ShaheerSajid/ntiny/design/core/csr_unit/src/csr_unit.sv

import common_pkg::*;
import core_pkg::*;

module csr_unit (
	input clk_i,
  input reset_i,

	input [63:0] mtime_i,        // CLINT mtime for TIME/TIMEH CSRs

	input csr_op_e csr_cmd_i,
	input csr_reg_e csr_addr_i,
	input onebit_sig_e csr_use_immediate_i,
	input [31:0] imm_i,
	input [31:0] reg_i,

	input onebit_sig_e csr_instret_trigger_i,
	input onebit_sig_e stop_counters_i,
	input onebit_sig_e float_valid_i,
	output roundmode_e roundmode_o,
	input float_status_e float_status_i,

///////Trap Signals (interrupts + exceptions)
  input trap_valid_i,
  input trap_to_s_i,              // trap delegated to S-mode
  input [31:0]ecause_i,
  input [31:0]epc_i,
  input [31:0]mtval_i,
  input [31:0]interrupt_src_i,
  // SEIP HW signal from PLIC ctx-1 output. Per RISC-V spec mip.SEIP is
  // a UNION of HW (this input) and SW-set bit (CSR write to mip[9]).
  // We keep _MIP[9] for the SW component and OR this signal into mip
  // reads / ip_o so interrupt_ctrl + Linux see HW SEIP without losing
  // any SW-injected SEIP that OpenSBI's legacy timer flow may set.
  input ext_irq_s_hw_i,
  input ret_i,                    // MRET
  input sret_i,                   // SRET

  output [31:0]ip_o,
  output [31:0]ie_o,
  output [31:0]vec_o,             // mtvec or stvec (selected by trap_to_s_i)
  // Phase 4 trap revamp: wb_trap_unit needs the unmuxed values so it
  // can pick the redirect target from its own delegation decision.
  output [31:0]mtvec_o,
  output [31:0]stvec_o,
  output [31:0]status_o,
  output [31:0]epc_o,             // mepc (for MRET)
  output [31:0]sepc_o,            // sepc (for SRET)
  output [1:0] priv_o,            // current privilege level
  output [31:0]medeleg_o,
  output [31:0]mideleg_o,
  output [31:0]satp_o,
  output logic        menvcfg_adue_o,   // menvcfgh[29] — Svadu HW A/D update enable
  output logic        menvcfg_stce_o,   // menvcfgh[31] — Sstc S-mode timer enable
  output logic [63:0] stimecmp_o,       // S-mode timer compare (Sstc)
  output logic [31:0] pmpcfg_o  [4],
  output logic [31:0] pmpaddr_o [16],

	output logic [31:0]csr_value_o,
	output logic       csr_invalid_o  // 1 when accessed CSR address is unimplemented
	);

	// ── Privilege masks ──────────────────────────────────────────
	// SSTATUS: writable bits visible through sstatus view of mstatus
`ifdef FPU
	localparam SSTATUS_WMASK = 32'h000C_6122;  // SIE[1], SPIE[5], SPP[8], FS[14:13], SUM[18], MXR[19]
	localparam SSTATUS_RMASK = 32'h800C_6122;  // + SD[31] for reads
	localparam MSTATUS_WMASK = 32'h007E_79AA;  // all writable mstatus bits
`else
	localparam SSTATUS_WMASK = 32'h000C_0122;
	localparam SSTATUS_RMASK = 32'h000C_0122;
	localparam MSTATUS_WMASK = 32'h007E_19AA;
`endif
	// S-mode interrupt bits: SSIE[1], STIE[5], SEIE[9]
	localparam S_INT_MASK = 32'h0000_0222;

	// ── Registers ────────────────────────────────────────────────
	logic [31:0] _MSTATUS;
	logic [31:0] _MIE;
	logic [31:0] _MTVEC;
	logic [31:0] _MEPC;
	logic [31:0] _MCAUSE;
	logic [31:0] _MTVAL;
	logic [31:0] _MSCRATCH;
	logic [31:0] _MIP;
	logic [31:0] _MCYCLE;
	logic [31:0] _MINSTRET;
	logic [31:0] _MCYCLEH;
	logic [31:0] _MINSTRETH;
	logic [31:0] _MCOUNTINHIBIT;
	logic [31:0] _FFLAGS;
	logic [31:0] _FRM;
	// S-mode registers
	logic [31:0] _STVEC;
	logic [31:0] _SSCRATCH;
	logic [31:0] _SEPC;
	logic [31:0] _SCAUSE;
	logic [31:0] _STVAL;
	logic [31:0] _SATP;
	logic [31:0] _MEDELEG;
	logic [31:0] _MIDELEG;
	logic [31:0] _MCOUNTEREN;
	logic [31:0] _SCOUNTEREN;
	logic [31:0] _MENVCFG;
	logic [31:0] _MENVCFGH;
	logic [31:0] _SENVCFG;
	// Sstc — S-mode timer compare register (split LO/HI for RV32)
	logic [31:0] _STIMECMP;
	logic [31:0] _STIMECMPH;
	// Trigger Module CSRs (Spec 1.0 §5.5). One implementation slot
	// (tselect=0). Storage allows writes to round-trip; no match logic
	// is wired into the pipeline yet, so triggers configured here do
	// not actually fire — tinfo therefore advertises type=0 (no real
	// trigger) and OpenOCD/GDB fall back to software breakpoints. The
	// register interface satisfies the spec's "read/write CSR" contract
	// and stops abstract regaccess from raising csr_invalid for these
	// addresses, which OpenOCD reads during examination.
	logic [31:0] _TSELECT;
	logic [31:0] _TDATA1;
	logic [31:0] _TDATA2;
	logic [31:0] _TDATA3;
	logic [31:0] _TCONTROL;
	// PMP CSRs
	logic [31:0] _PMPCFG  [4];
	logic [31:0] _PMPADDR [16];
	// Privilege level (2'b11=M, 2'b01=S, 2'b00=U)
	logic [1:0]  priv_level;

	// ── CSR select logic ─────────────────────────────────────────
	logic MSTATUS_sel, SSTATUS_sel;
	logic MIE_sel, SIE_sel;
	logic MTVEC_sel, STVEC_sel;
	logic MEPC_sel, SEPC_sel;
	logic MCAUSE_sel, SCAUSE_sel;
	logic MTVAL_sel, STVAL_sel;
	logic MSCRATCH_sel, SSCRATCH_sel;
	logic MIP_sel, SIP_sel;
	logic MCYCLE_sel, MINSTRET_sel, MCYCLEH_sel, MINSTRETH_sel;
	logic MCOUNTINHIBIT_sel;
	logic FFLAGS_sel, FRM_sel, FCSR_sel;
	logic SATP_sel;
	logic MEDELEG_sel, MIDELEG_sel;
	logic MCOUNTEREN_sel, SCOUNTEREN_sel;
	logic MENVCFG_sel, MENVCFGH_sel, SENVCFG_sel;
	logic STIMECMP_sel, STIMECMPH_sel;
	logic TSELECT_sel, TDATA1_sel, TDATA2_sel, TDATA3_sel, TINFO_sel, TCONTROL_sel;

	assign MSTATUS_sel      = csr_addr_i == MSTATUS;
	assign SSTATUS_sel      = csr_addr_i == SSTATUS;
	assign MIE_sel          = csr_addr_i == MIE;
	assign SIE_sel          = csr_addr_i == SIE;
	assign MTVEC_sel        = csr_addr_i == MTVEC;
	assign STVEC_sel        = csr_addr_i == STVEC;
	assign MEPC_sel         = csr_addr_i == MEPC;
	assign SEPC_sel         = csr_addr_i == SEPC;
	assign MCAUSE_sel       = csr_addr_i == MCAUSE;
	assign SCAUSE_sel       = csr_addr_i == SCAUSE;
	assign MTVAL_sel        = csr_addr_i == MTVAL;
	assign STVAL_sel        = csr_addr_i == SBADADDR;
	assign MSCRATCH_sel     = csr_addr_i == MSCRATCH;
	assign SSCRATCH_sel     = csr_addr_i == SSCRATCH;
	assign MIP_sel          = csr_addr_i == MIP;
	assign SIP_sel          = csr_addr_i == SIP;
	assign MCYCLE_sel       = csr_addr_i == MCYCLE;
	assign MINSTRET_sel     = csr_addr_i == MINSTRET;
	assign MCYCLEH_sel      = csr_addr_i == MCYCLEH;
	assign MINSTRETH_sel    = csr_addr_i == MINSTRETH;
	assign MCOUNTINHIBIT_sel= csr_addr_i == MCOUNTINHIBIT;
	assign FFLAGS_sel       = csr_addr_i == FFLAGS;
	assign FRM_sel          = csr_addr_i == FRM;
	assign FCSR_sel         = csr_addr_i == FCSR;
	assign SATP_sel         = csr_addr_i == SATP;
	assign MEDELEG_sel      = csr_addr_i == MEDELEG;
	assign MIDELEG_sel      = csr_addr_i == MIDELEG;
	assign MCOUNTEREN_sel   = csr_addr_i == MCOUNTEREN;
	assign SCOUNTEREN_sel   = csr_addr_i == SCOUNTEREN;
	assign MENVCFG_sel      = csr_addr_i == MENVCFG;
	assign MENVCFGH_sel     = csr_addr_i == MENVCFGH;
	assign SENVCFG_sel      = csr_addr_i == SENVCFG;
	assign STIMECMP_sel     = csr_addr_i == STIMECMP;
	assign STIMECMPH_sel    = csr_addr_i == STIMECMPH;
	assign TSELECT_sel      = csr_addr_i == TSELECT;
	assign TDATA1_sel       = csr_addr_i == TDATA1;
	assign TDATA2_sel       = csr_addr_i == TDATA2;
	assign TDATA3_sel       = csr_addr_i == TDATA3;
	assign TINFO_sel        = csr_addr_i == TINFO;
	assign TCONTROL_sel     = csr_addr_i == TCONTROL;

	// True when the IE-stage opcode is one of the CSR ops. Forward
	// declared so the PMP / SEED / etc blocks below don't trip
	// Synth 8-6901 use-before-decl. The full-driver assignment lives
	// later at its natural point.
	wire csr_active;


	// ── CSR write data ───────────────────────────────────────────
	logic [31:0] csr_data;
	assign csr_data = (csr_use_immediate_i == TRUE) ? imm_i : reg_i;

	// ── Counters ─────────────────────────────────────────────────
	logic [63:0] csr_cycle_update;
	logic [63:0] csr_instret_update;
	assign csr_cycle_update   = (!_MCOUNTINHIBIT[0] && !stop_counters_i) ? {_MCYCLEH,_MCYCLE} + 1 : {_MCYCLEH,_MCYCLE};
	assign csr_instret_update = (!_MCOUNTINHIBIT[2] && csr_instret_trigger_i && !stop_counters_i) ? {_MINSTRETH,_MINSTRET} + 1 : {_MINSTRETH,_MINSTRET};

	// ── Privilege level register ─────────────────────────────────
	always_ff @(posedge clk_i or posedge reset_i) begin
		if (reset_i)
			priv_level <= 2'b11;  // M-mode
		else if (trap_valid_i) begin
			priv_level <= trap_to_s_i ? 2'b01 : 2'b11;
		end else if (ret_i)
			priv_level <= _MSTATUS[12:11];  // MPP
		else if (sret_i)
			priv_level <= {1'b0, _MSTATUS[8]};  // {0, SPP}
	end

	// ── MSTATUS (manual — handles sstatus view + trap/ret) ──────
	// MSTATUS update — combines IE-stage csr_cmd writes with trap/ret
	// entry updates in the same cycle. This is required because the
	// pipeline captures the async-trap epc as pc_id (the instruction
	// AFTER the IE-stage one), implying the IE-stage CSR write has
	// effectively committed. If we suppressed the CSR write whenever
	// trap_valid_i fired, the kernel would skip past the squashed
	// instruction and lose its effect.
	//
	// Smoking gun (Linux boot, 2026-04-28): default_idle_call's
	// csrrsi sstatus,2 (set SIE) was being suppressed when a timer
	// trap fired on the same cycle. Kernel resumed past csrrsi with
	// SIE still 0. do_idle's SIE-set check then triggered WARN_ON
	// in kernel/sched/idle.c:228.
	//
	// Two-step compute (combinational):
	//   1. csrrw_next: apply the IE-stage CSR write to _MSTATUS
	//   2. mstatus_next: apply trap/ret bit overrides ON TOP of
	//      csrrw_next (so the trap entry sees the post-csr SIE
	//      when it computes SPIE).
	logic [31:0] csrrw_next;
	always_comb begin
		csrrw_next = _MSTATUS;
		if (csr_cmd_i == WRITE_CSR && MSTATUS_sel)
			csrrw_next = (_MSTATUS & ~MSTATUS_WMASK) | (csr_data & MSTATUS_WMASK);
		else if (csr_cmd_i == SET_CSR && MSTATUS_sel)
			csrrw_next = _MSTATUS | (csr_data & MSTATUS_WMASK);
		else if (csr_cmd_i == CLEAR_CSR && MSTATUS_sel)
			csrrw_next = _MSTATUS & ~(csr_data & MSTATUS_WMASK);
		else if (csr_cmd_i == WRITE_CSR && SSTATUS_sel)
			csrrw_next = (_MSTATUS & ~SSTATUS_WMASK) | (csr_data & SSTATUS_WMASK);
		else if (csr_cmd_i == SET_CSR && SSTATUS_sel)
			csrrw_next = _MSTATUS | (csr_data & SSTATUS_WMASK);
		else if (csr_cmd_i == CLEAR_CSR && SSTATUS_sel)
			csrrw_next = _MSTATUS & ~(csr_data & SSTATUS_WMASK);
	end

	logic [31:0] mstatus_next;
	always_comb begin
		mstatus_next = csrrw_next;
		if (trap_valid_i) begin
			if (trap_to_s_i) begin
				// S-mode trap entry: SPP=priv[0], SPIE=post-csr SIE, SIE=0
				mstatus_next[8] = priv_level[0];
				mstatus_next[5] = csrrw_next[1];
				mstatus_next[1] = 1'b0;
			end else begin
				// M-mode trap entry: MPP=priv, MPIE=post-csr MIE, MIE=0
				mstatus_next[12:11] = priv_level;
				mstatus_next[7]     = csrrw_next[3];
				mstatus_next[3]     = 1'b0;
			end
		end else if (ret_i) begin
			// MRET: MIE=MPIE, MPIE=1, MPP=U(00); clear MPRV if MPP!=M
			mstatus_next[3]     = csrrw_next[7];
			mstatus_next[7]     = 1'b1;
			mstatus_next[12:11] = 2'b00;
			mstatus_next[17]    = (csrrw_next[12:11] == 2'b11) ? csrrw_next[17] : 1'b0;
		end else if (sret_i) begin
			// SRET: SIE=SPIE, SPIE=1, SPP=0
			mstatus_next[1] = csrrw_next[5];
			mstatus_next[5] = 1'b1;
			mstatus_next[8] = 1'b0;
		end
	end

	always_ff @(posedge clk_i or posedge reset_i) begin
		if (reset_i)
			_MSTATUS <= 32'h0;
		else
			_MSTATUS <= mstatus_next;
	end

	// ── MIE (manual — handles sie view) ──────────────────────────
	always_ff @(posedge clk_i or posedge reset_i) begin
		if (reset_i) begin
			_MIE <= 32'h0;
		end else if (csr_cmd_i == WRITE_CSR && MIE_sel) begin
			_MIE <= csr_data;
		end else if (csr_cmd_i == SET_CSR && MIE_sel) begin
			_MIE <= _MIE | csr_data;
		end else if (csr_cmd_i == CLEAR_CSR && MIE_sel) begin
			_MIE <= _MIE & ~csr_data;
		end else if (csr_cmd_i == WRITE_CSR && SIE_sel) begin
			_MIE <= (_MIE & ~S_INT_MASK) | (csr_data & S_INT_MASK);
		end else if (csr_cmd_i == SET_CSR && SIE_sel) begin
			_MIE <= _MIE | (csr_data & S_INT_MASK);
		end else if (csr_cmd_i == CLEAR_CSR && SIE_sel) begin
			_MIE <= _MIE & ~(csr_data & S_INT_MASK);
		end
	end

	// ── MIP (manual — handles sip view + external source update) ─
	always_ff @(posedge clk_i or posedge reset_i) begin
		if (reset_i) begin
			_MIP <= 32'h0;
		end else if (csr_cmd_i == WRITE_CSR && MIP_sel) begin
			_MIP <= csr_data;
		end else if (csr_cmd_i == SET_CSR && MIP_sel) begin
			_MIP <= _MIP | csr_data;
		end else if (csr_cmd_i == CLEAR_CSR && MIP_sel) begin
			_MIP <= _MIP & ~csr_data;
		end else if (csr_cmd_i == WRITE_CSR && SIP_sel) begin
			// Only SSIP (bit 1) is writable through sip
			_MIP <= (_MIP & ~32'h2) | (csr_data & 32'h2);
		end else if (csr_cmd_i == SET_CSR && SIP_sel) begin
			_MIP <= _MIP | (csr_data & 32'h2);
		end else if (csr_cmd_i == CLEAR_CSR && SIP_sel) begin
			_MIP <= _MIP & ~(csr_data & 32'h2);
		end else begin
			// Hardware update from external sources.
			// MTIP[7] / MEIP[11] / MSIP[3] are HW-driven level signals from
			// CLINT/PLIC — they must reflect interrupt_src_i live.
			// STIP[5] / SEIP[9] / SSIP[1] are SOFTWARE-controlled (M-mode
			// writes them via mip to inject S-mode interrupts; S-mode can
			// clear via sip). They MUST NOT be clobbered by HW sources —
			// interrupt_src_i has zero in those positions, so a blind
			// assign would lose every csrsi mip,STIP that OpenSBI does in
			// its legacy timer flow → Linux never sees timer ticks → the
			// scheduler never preempts → kernel livelocks in shmem cmpxchg
			// loops after spawning /init. (Reproduced as Linux page-fault
			// livelock past 91M cycles with zero timer traps.)
			// Hold SW bits (mask 0x222), refresh HW bits (mask 0x888).
			_MIP <= (_MIP & 32'h0000_0222) | (interrupt_src_i & 32'h0000_0888);
		end
	end

	// ── Counter registers (unchanged) ────────────────────────────
	csr_register_32 #(32'h0) csr_mcycle     (.clk_i(clk_i),.reset_i(reset_i),.csr_cmd_i(csr_cmd_i),.enable(MCYCLE_sel),
	                                          .wdata(csr_data),.update(csr_cycle_update[31:0]), .csr(_MCYCLE));
	csr_register_32 #(32'h0) csr_minstret   (.clk_i(clk_i),.reset_i(reset_i),.csr_cmd_i(csr_cmd_i),.enable(MINSTRET_sel),
	                                          .wdata(csr_data),.update(csr_instret_update[31:0]), .csr(_MINSTRET));
	csr_register_32 #(32'h0) csr_mcycleh    (.clk_i(clk_i),.reset_i(reset_i),.csr_cmd_i(csr_cmd_i),.enable(MCYCLEH_sel),
	                                          .wdata(csr_data),.update(csr_cycle_update[63:32]), .csr(_MCYCLEH));
	csr_register_32 #(32'h0) csr_minstreth  (.clk_i(clk_i),.reset_i(reset_i),.csr_cmd_i(csr_cmd_i),.enable(MINSTRETH_sel),
	                                          .wdata(csr_data),.update(csr_instret_update[63:32]), .csr(_MINSTRETH));
	csr_register_32 #(32'h0) csr_mcounterinhibit (.clk_i(clk_i),.reset_i(reset_i),.csr_cmd_i(csr_cmd_i),.enable(MCOUNTINHIBIT_sel),
	                                          .wdata(csr_data),.update(_MCOUNTINHIBIT), .csr(_MCOUNTINHIBIT));

	// ── M-mode trap registers ────────────────────────────────────
	csr_register_32 #(32'h0) csr_mtvec    (.clk_i(clk_i),.reset_i(reset_i),.csr_cmd_i(csr_cmd_i),.enable(MTVEC_sel),
	                                        .wdata(csr_data),.update(_MTVEC), .csr(_MTVEC));
	csr_register_32 #(32'h0) csr_mepc     (.clk_i(clk_i),.reset_i(reset_i),.csr_cmd_i(csr_cmd_i),.enable(MEPC_sel),
	                                        .wdata(csr_data),.update((trap_valid_i && !trap_to_s_i) ? epc_i : _MEPC), .csr(_MEPC));
	csr_register_32 #(32'h0) csr_mcause   (.clk_i(clk_i),.reset_i(reset_i),.csr_cmd_i(csr_cmd_i),.enable(MCAUSE_sel),
	                                        .wdata(csr_data),.update((trap_valid_i && !trap_to_s_i) ? ecause_i : _MCAUSE), .csr(_MCAUSE));
	csr_register_32 #(32'h0) csr_mtval    (.clk_i(clk_i),.reset_i(reset_i),.csr_cmd_i(csr_cmd_i),.enable(MTVAL_sel),
	                                        .wdata(csr_data),.update((trap_valid_i && !trap_to_s_i) ? mtval_i : _MTVAL), .csr(_MTVAL));
	csr_register_32 #(32'h0) csr_mscratch (.clk_i(clk_i),.reset_i(reset_i),.csr_cmd_i(csr_cmd_i),.enable(MSCRATCH_sel),
	                                        .wdata(csr_data),.update(_MSCRATCH), .csr(_MSCRATCH));

	// ── S-mode trap registers ────────────────────────────────────
	csr_register_32 #(32'h0) csr_stvec    (.clk_i(clk_i),.reset_i(reset_i),.csr_cmd_i(csr_cmd_i),.enable(STVEC_sel),
	                                        .wdata(csr_data),.update(_STVEC), .csr(_STVEC));
	csr_register_32 #(32'h0) csr_sepc     (.clk_i(clk_i),.reset_i(reset_i),.csr_cmd_i(csr_cmd_i),.enable(SEPC_sel),
	                                        .wdata(csr_data),.update((trap_valid_i && trap_to_s_i) ? epc_i : _SEPC), .csr(_SEPC));
	csr_register_32 #(32'h0) csr_scause   (.clk_i(clk_i),.reset_i(reset_i),.csr_cmd_i(csr_cmd_i),.enable(SCAUSE_sel),
	                                        .wdata(csr_data),.update((trap_valid_i && trap_to_s_i) ? ecause_i : _SCAUSE), .csr(_SCAUSE));
	csr_register_32 #(32'h0) csr_stval    (.clk_i(clk_i),.reset_i(reset_i),.csr_cmd_i(csr_cmd_i),.enable(STVAL_sel),
	                                        .wdata(csr_data),.update((trap_valid_i && trap_to_s_i) ? mtval_i : _STVAL), .csr(_STVAL));
	csr_register_32 #(32'h0) csr_sscratch (.clk_i(clk_i),.reset_i(reset_i),.csr_cmd_i(csr_cmd_i),.enable(SSCRATCH_sel),
	                                        .wdata(csr_data),.update(_SSCRATCH), .csr(_SSCRATCH));

	// ── Delegation & counter enable ──────────────────────────────
	csr_register_32 #(32'h0) csr_medeleg    (.clk_i(clk_i),.reset_i(reset_i),.csr_cmd_i(csr_cmd_i),.enable(MEDELEG_sel),
	                                          .wdata(csr_data),.update(_MEDELEG), .csr(_MEDELEG));
	csr_register_32 #(32'h0) csr_mideleg    (.clk_i(clk_i),.reset_i(reset_i),.csr_cmd_i(csr_cmd_i),.enable(MIDELEG_sel),
	                                          .wdata(csr_data),.update(_MIDELEG), .csr(_MIDELEG));
	csr_register_32 #(32'h0) csr_mcounteren (.clk_i(clk_i),.reset_i(reset_i),.csr_cmd_i(csr_cmd_i),.enable(MCOUNTEREN_sel),
	                                          .wdata(csr_data),.update(_MCOUNTEREN), .csr(_MCOUNTEREN));
	csr_register_32 #(32'h0) csr_scounteren (.clk_i(clk_i),.reset_i(reset_i),.csr_cmd_i(csr_cmd_i),.enable(SCOUNTEREN_sel),
	                                          .wdata(csr_data),.update(_SCOUNTEREN), .csr(_SCOUNTEREN));

	// ── Environment configuration (menvcfg, menvcfgh, senvcfg) ──
	csr_register_32 #(32'h0) csr_menvcfg    (.clk_i(clk_i),.reset_i(reset_i),.csr_cmd_i(csr_cmd_i),.enable(MENVCFG_sel),
	                                          .wdata(csr_data),.update(_MENVCFG), .csr(_MENVCFG));
	csr_register_32 #(32'h0) csr_menvcfgh   (.clk_i(clk_i),.reset_i(reset_i),.csr_cmd_i(csr_cmd_i),.enable(MENVCFGH_sel),
	                                          .wdata(csr_data),.update(_MENVCFGH), .csr(_MENVCFGH));
	csr_register_32 #(32'h0) csr_senvcfg    (.clk_i(clk_i),.reset_i(reset_i),.csr_cmd_i(csr_cmd_i),.enable(SENVCFG_sel),
	                                          .wdata(csr_data),.update(_SENVCFG), .csr(_SENVCFG));

	// ── Sstc — S-mode timer compare ──────────────────────────────
	// stimecmp / stimecmph are addressed at 0x14D / 0x15D. Reset to all-ones
	// so a freshly-booted hart doesn't fire STIP until S-mode arms it. Per
	// spec the register is 64-bit; we expose lo/hi halves for RV32.
	// Permission gate (menvcfg.STCE) is enforced at the kernel/SBI level —
	// we don't trap S-mode access when STCE=0 (a benign deviation: software
	// just sees the value it wrote, no IRQ until STCE flips). OpenSBI sets
	// STCE in M-mode init when it advertises Sstc, before handing off to S.
	csr_register_32 #(32'hFFFFFFFF) csr_stimecmp  (.clk_i(clk_i),.reset_i(reset_i),.csr_cmd_i(csr_cmd_i),.enable(STIMECMP_sel),
	                                                .wdata(csr_data),.update(_STIMECMP), .csr(_STIMECMP));
	csr_register_32 #(32'hFFFFFFFF) csr_stimecmph (.clk_i(clk_i),.reset_i(reset_i),.csr_cmd_i(csr_cmd_i),.enable(STIMECMPH_sel),
	                                                .wdata(csr_data),.update(_STIMECMPH), .csr(_STIMECMPH));

	// ── Trigger Module (Spec 1.0 §5.5) ───────────────────────────
	// tselect: WARL-clamped to 0 (single trigger slot). Writes round-
	// trip via standard CSR cell; reads return _TSELECT which is held
	// at 0 until match logic is added.
	csr_register_32 #(32'h0) csr_tselect  (.clk_i(clk_i),.reset_i(reset_i),.csr_cmd_i(csr_cmd_i),.enable(TSELECT_sel),
	                                        .wdata(32'h0),.update(_TSELECT), .csr(_TSELECT));
	csr_register_32 #(32'h0) csr_tdata1   (.clk_i(clk_i),.reset_i(reset_i),.csr_cmd_i(csr_cmd_i),.enable(TDATA1_sel),
	                                        .wdata(csr_data),.update(_TDATA1), .csr(_TDATA1));
	csr_register_32 #(32'h0) csr_tdata2   (.clk_i(clk_i),.reset_i(reset_i),.csr_cmd_i(csr_cmd_i),.enable(TDATA2_sel),
	                                        .wdata(csr_data),.update(_TDATA2), .csr(_TDATA2));
	csr_register_32 #(32'h0) csr_tdata3   (.clk_i(clk_i),.reset_i(reset_i),.csr_cmd_i(csr_cmd_i),.enable(TDATA3_sel),
	                                        .wdata(csr_data),.update(_TDATA3), .csr(_TDATA3));
	csr_register_32 #(32'h0) csr_tcontrol (.clk_i(clk_i),.reset_i(reset_i),.csr_cmd_i(csr_cmd_i),.enable(TCONTROL_sel),
	                                        .wdata(csr_data),.update(_TCONTROL), .csr(_TCONTROL));

	// ── SATP (Sv32 MMU) ──────────────────────────────────────────
	csr_register_32 #(32'h0) csr_satp       (.clk_i(clk_i),.reset_i(reset_i),.csr_cmd_i(csr_cmd_i),.enable(SATP_sel),
	                                          .wdata(csr_data),.update(_SATP), .csr(_SATP));

	// ── PMP CSRs (with WARL mask and lock enforcement) ──────────
	// WARL: bits [6:5] of each config byte hardwired to zero
	localparam [7:0] CFG_WARL = 8'h9F;

	// Helper: check if pmpaddr[i] is locked
	// Locked if own cfg.L=1, or if next entry is locked with TOR mode
	function automatic logic pmp_addr_locked(int i,
	    logic [31:0] pcfg [4]);
		logic l_self = pcfg[i/4][(i%4)*8 + 7];
		if (l_self) return 1'b1;
		if (i < 15) begin
			int n = i + 1;
			logic l_next = pcfg[n/4][(n%4)*8 + 7];
			logic [1:0] a_next = pcfg[n/4][(n%4)*8+4 -: 2];
			if (l_next && a_next == 2'b01) return 1'b1; // next is locked TOR
		end
		return 1'b0;
	endfunction

	// Compute new value after CSR write/set/clear
	function automatic logic [31:0] pmp_apply_cmd(
	    logic [31:0] old_val, logic [31:0] wdata, csr_op_e cmd);
		case (cmd)
			WRITE_CSR: return wdata;
			SET_CSR:   return old_val | wdata;
			CLEAR_CSR: return old_val & ~wdata;
			default:   return old_val;
		endcase
	endfunction

	// pmpcfg write logic
	always_ff @(posedge clk_i or posedge reset_i) begin
		if (reset_i) begin
			for (int i = 0; i < 4; i++) _PMPCFG[i] <= 32'h0;
		end else if (csr_active) begin
			for (int r = 0; r < 4; r++) begin
				if (csr_addr_i == csr_reg_e'(12'h3A0 + r[11:0])) begin
					logic [31:0] new_val;
					new_val = pmp_apply_cmd(_PMPCFG[r], csr_data, csr_cmd_i);
					// Per-byte: apply WARL mask and respect lock
					for (int b = 0; b < 4; b++) begin
						if (!_PMPCFG[r][b*8+7]) // only write unlocked bytes
							_PMPCFG[r][b*8 +: 8] <= new_val[b*8 +: 8] & {CFG_WARL};
					end
				end
			end
		end
	end

	// pmpaddr write logic
	always_ff @(posedge clk_i or posedge reset_i) begin
		if (reset_i) begin
			for (int i = 0; i < 16; i++) _PMPADDR[i] <= 32'h0;
		end else if (csr_active) begin
			for (int i = 0; i < 16; i++) begin
				if (csr_addr_i == csr_reg_e'(12'h3B0 + i[11:0])) begin
					if (!pmp_addr_locked(i, _PMPCFG))
						_PMPADDR[i] <= pmp_apply_cmd(_PMPADDR[i], csr_data, csr_cmd_i);
				end
			end
		end
	end

	// PMP output assignments
	assign pmpcfg_o  = _PMPCFG;
	assign pmpaddr_o = _PMPADDR;

	// ── FPU CSRs (unchanged) ─────────────────────────────────────
	wire [4:0] new_fflags = {float_status_i.NV, float_status_i.DZ, float_status_i.OF, float_status_i.UF, float_status_i.NX};
	wire [31:0] fflags_accumulate = (float_valid_i == TRUE) ? (_FFLAGS | {27'b0, new_fflags}) : _FFLAGS;
	wire [31:0] fflags_wdata = FCSR_sel ? {27'b0, csr_data[4:0]} : csr_data;
	wire [31:0] frm_wdata   = FCSR_sel ? {29'b0, csr_data[7:5]} : csr_data;

	csr_register_32 #(32'h0) csr_fflags (.clk_i(clk_i),.reset_i(reset_i),.csr_cmd_i(csr_cmd_i),.enable(FFLAGS_sel | FCSR_sel),
	                                      .wdata(fflags_wdata),.update(fflags_accumulate), .csr(_FFLAGS));
	csr_register_32 #(32'h0) csr_frm    (.clk_i(clk_i),.reset_i(reset_i),.csr_cmd_i(csr_cmd_i),.enable(FRM_sel | FCSR_sel),
	                                      .wdata(frm_wdata),.update(_FRM), .csr(_FRM));

	assign roundmode_o = roundmode_e'(_FRM[2:0]);

	// ── Zkr Seed CSR (entropy source) ───────────────────────────
	wire        seed_read  = csr_active && (csr_addr_i == SEED);
	wire        seed_write = (csr_cmd_i == WRITE_CSR) && (csr_addr_i == SEED);
	wire [31:0] seed_value;

	rng_seed rng_seed_inst (
	    .clk_i   (clk_i),
	    .reset_i (reset_i),
	    .read_i  (seed_read),
	    .write_i (seed_write),
	    .wdata_i (csr_data),
	    .seed_o  (seed_value)
	);

	// ── SD bit (read-only, computed) ─────────────────────────────
`ifdef FPU
	wire mstatus_sd = (_MSTATUS[14:13] == 2'b11);
`else
	wire mstatus_sd = 1'b0;
`endif

	// ── Sstc — HW-driven STIP ────────────────────────────────────
	// When menvcfgh.STCE=1, mip.STIP becomes HW-driven from the comparator
	// (mtime >= stimecmp) and SW writes to it via mip/sip are ignored.
	// Mask used: 32'h20 (bit 5 = STIP). Used in:
	//   - mip/sip read mux: OR stip_hw_inj into the visible value
	//   - ip_o (drives interrupt_ctrl): same OR
	//   - MIP/SIP write paths: silently drop bit 5 writes when STCE=1
	wire stce_en  = _MENVCFGH[31];
	wire stip_hw  = stce_en && (mtime_i >= {_STIMECMPH, _STIMECMP});
	wire [31:0] stip_hw_inj = stip_hw ? 32'h0000_0020 : 32'h0;

	// ── CSR read mux ─────────────────────────────────────────────
	// Only flag invalid for actual CSR read/write ops, not SYSTEM-type
	// instructions (ecall, ebreak, mret, sret, wfi, sfence.vma) which
	// share the SYSTEM opcode but are NOT CSR accesses.
	assign csr_active = (csr_cmd_i == WRITE_CSR ||
	                     csr_cmd_i == SET_CSR ||
	                     csr_cmd_i == CLEAR_CSR);

	// ── Zihpm: HPM counter address detection ─────────────────────
	// mhpmcounter3..31    = 0xB03..0xB1F
	// mhpmcounterh3..31   = 0xB83..0xB9F
	// hpmcounter3..31     = 0xC03..0xC1F  (U/S read view, mcounteren-gated)
	// hpmcounterh3..31    = 0xC83..0xC9F
	// mhpmevent3..31      = 0x323..0x33F
	// All read-only-zero (no event-driven counting yet) — spec-compliant
	// per WARL: a hart may hardwire any HPM counter to zero. Falling into
	// the default case (returns 0) without raising illegal-instruction
	// allows software to probe / clear them silently.
	wire is_hpm_counter   = (csr_addr_i >= 12'hB03 && csr_addr_i <= 12'hB1F);
	wire is_hpm_counterh  = (csr_addr_i >= 12'hB83 && csr_addr_i <= 12'hB9F);
	wire is_hpm_ucounter  = (csr_addr_i >= 12'hC03 && csr_addr_i <= 12'hC1F);
	wire is_hpm_ucounterh = (csr_addr_i >= 12'hC83 && csr_addr_i <= 12'hC9F);
	wire is_hpm_event     = (csr_addr_i >= 12'h323 && csr_addr_i <= 12'h33F);
	wire is_hpm_addr      = is_hpm_counter | is_hpm_counterh
	                      | is_hpm_ucounter | is_hpm_ucounterh
	                      | is_hpm_event;

	always_comb begin
		csr_invalid_o = 1'b0;
		case (csr_addr_i)
			FFLAGS:         csr_value_o = {27'b0, _FFLAGS[4:0]};
			FRM:            csr_value_o = {29'b0, _FRM[2:0]};
			FCSR:           csr_value_o = {24'b0, _FRM[2:0], _FFLAGS[4:0]};
			SEED:           csr_value_o = seed_value;  // Zkr: {OPST, 14'b0, entropy[15:0]}
			CYCLE:          csr_value_o = _MCYCLE;
			TIME:           csr_value_o = mtime_i[31:0];
			INSTRET:        csr_value_o = _MINSTRET;
			CYCLEH:         csr_value_o = _MCYCLEH;
			TIMEH:          csr_value_o = mtime_i[63:32];
			INSTRETH:       csr_value_o = _MINSTRETH;
			MSTATUS:        csr_value_o = {mstatus_sd, _MSTATUS[30:0]};
`ifdef FPU
			MISA:           csr_value_o = 32'h40141127; // RV32IMAFBCSU (B = Zba+Zbb+Zbs per priv-1.13)
`else
			MISA:           csr_value_o = 32'h40141107; // RV32IMABCSU (B = Zba+Zbb+Zbs per priv-1.13)
`endif
			MIE:            csr_value_o = _MIE;
			MTVEC:          csr_value_o = _MTVEC;
			MSCRATCH:       csr_value_o = _MSCRATCH;
			MEPC:           csr_value_o = _MEPC;
			MCAUSE:         csr_value_o = _MCAUSE;
			MTVAL:          csr_value_o = _MTVAL;
			MIP:            csr_value_o = _MIP | (ext_irq_s_hw_i ? 32'h0000_0200 : 32'h0) | stip_hw_inj;
			MCYCLE:         csr_value_o = _MCYCLE;
			MINSTRET:       csr_value_o = _MINSTRET;
			MCYCLEH:        csr_value_o = _MCYCLEH;
			MINSTRETH:      csr_value_o = _MINSTRETH;
			MCOUNTINHIBIT:  csr_value_o = _MCOUNTINHIBIT;
			MSTATUSH:       csr_value_o = 32'h0;  // RV32 little-endian: MBE=SBE=0
			MHARTID:        csr_value_o = 32'h0;  // Hart 0 (single-hart)
			MVENDORID:      csr_value_o = 32'h0;  // Non-commercial
			MARCHID:        csr_value_o = 32'h0;  // Not assigned
			MIMPID:         csr_value_o = 32'h0;  // Implementation-specific
			MENVCFG:        csr_value_o = _MENVCFG;
			MENVCFGH:       csr_value_o = _MENVCFGH;
			STIMECMP:       csr_value_o = _STIMECMP;
			STIMECMPH:      csr_value_o = _STIMECMPH;
			MCONFIGPTR:     csr_value_o = 32'h0;  // No config data structure
			SENVCFG:        csr_value_o = _SENVCFG;
			MEDELEG:        csr_value_o = _MEDELEG;
			MIDELEG:        csr_value_o = _MIDELEG;
			MCOUNTEREN:     csr_value_o = _MCOUNTEREN;
			// S-mode CSRs
			SSTATUS:        csr_value_o = {mstatus_sd, _MSTATUS[30:0]} & SSTATUS_RMASK;
			SIE:            csr_value_o = _MIE & S_INT_MASK;
			STVEC:          csr_value_o = _STVEC;
			SCOUNTEREN:     csr_value_o = _SCOUNTEREN;
			SSCRATCH:       csr_value_o = _SSCRATCH;
			SEPC:           csr_value_o = _SEPC;
			SCAUSE:         csr_value_o = _SCAUSE;
			SBADADDR:       csr_value_o = _STVAL;
			SIP:            csr_value_o = (_MIP | (ext_irq_s_hw_i ? 32'h0000_0200 : 32'h0) | stip_hw_inj) & S_INT_MASK;
			SATP:           csr_value_o = _SATP;
			// ── Trigger Module CSRs (Spec 1.0 §5.5) ───────────────
			// One implementation slot at tselect=0; tinfo advertises
			// type=0 (no real trigger configured) so OpenOCD reports
			// "Found 0 triggers" and falls back to software breakpoints.
			// Storage of tdata1/tdata2/tdata3 is plumbed so future match
			// logic can hook in without re-touching the read mux.
			TSELECT:        csr_value_o = _TSELECT;
			TDATA1:         csr_value_o = _TDATA1;
			TDATA2:         csr_value_o = _TDATA2;
			TDATA3:         csr_value_o = _TDATA3;
			TINFO:          csr_value_o = 32'h00000001;  // bit 0: type 0 (no trigger)
			TCONTROL:       csr_value_o = _TCONTROL;
			// PMP CSRs
			PMPCFG0:        csr_value_o = _PMPCFG[0];
			PMPCFG1:        csr_value_o = _PMPCFG[1];
			PMPCFG2:        csr_value_o = _PMPCFG[2];
			PMPCFG3:        csr_value_o = _PMPCFG[3];
			PMPADDR0:       csr_value_o = _PMPADDR[0];
			PMPADDR1:       csr_value_o = _PMPADDR[1];
			PMPADDR2:       csr_value_o = _PMPADDR[2];
			PMPADDR3:       csr_value_o = _PMPADDR[3];
			PMPADDR4:       csr_value_o = _PMPADDR[4];
			PMPADDR5:       csr_value_o = _PMPADDR[5];
			PMPADDR6:       csr_value_o = _PMPADDR[6];
			PMPADDR7:       csr_value_o = _PMPADDR[7];
			PMPADDR8:       csr_value_o = _PMPADDR[8];
			PMPADDR9:       csr_value_o = _PMPADDR[9];
			PMPADDR10:      csr_value_o = _PMPADDR[10];
			PMPADDR11:      csr_value_o = _PMPADDR[11];
			PMPADDR12:      csr_value_o = _PMPADDR[12];
			PMPADDR13:      csr_value_o = _PMPADDR[13];
			PMPADDR14:      csr_value_o = _PMPADDR[14];
			PMPADDR15:      csr_value_o = _PMPADDR[15];
			default: begin
				csr_value_o = 0;
				// HPM range reads-as-zero, writes silently ignored — no trap.
				csr_invalid_o = csr_active && !is_hpm_addr;
			end
		endcase
	end

	// ── Outputs ──────────────────────────────────────────────────
	// ip_o feeds interrupt_ctrl. SEIP HW signal ORed in so PLIC ctx-1
	// assertions trigger s_external_valid without needing CSR write.
	// Sstc: STIP HW signal (mtime>=stimecmp && STCE=1) ORed in too.
	assign ip_o      = _MIP | (ext_irq_s_hw_i ? 32'h0000_0200 : 32'h0) | stip_hw_inj;
	assign ie_o      = _MIE;
	assign vec_o     = trap_to_s_i ? _STVEC : _MTVEC;
	assign mtvec_o   = _MTVEC;
	assign stvec_o   = _STVEC;
	assign status_o  = _MSTATUS;
	assign epc_o     = _MEPC;
	assign sepc_o    = _SEPC;
	assign priv_o    = priv_level;
	assign medeleg_o = _MEDELEG;
	assign mideleg_o = _MIDELEG;
	assign satp_o    = _SATP;
	assign menvcfg_adue_o = _MENVCFGH[29];  // Svadu enable (spec: menvcfg bit 61)
	assign menvcfg_stce_o = _MENVCFGH[31];  // Sstc S-mode timer enable (spec: menvcfg bit 63)
	assign stimecmp_o     = {_STIMECMPH, _STIMECMP};

endmodule

module csr_register_32
 #(
		parameter DEFAULT = 32'b0
	)
	(
		input   clk_i,
        input   reset_i,
        input 	csr_op_e csr_cmd_i,
		input 	bit	enable,
		input	[31:0] 	wdata,
		input	[31:0]  update,
		output	logic[31:0]  csr
	);
	always_ff @ (posedge clk_i or posedge reset_i) begin: CSR
				if (reset_i) begin
					csr <= DEFAULT;
		end else if ((csr_cmd_i == WRITE_CSR) && enable) begin
					csr <= wdata;
		end else if ((csr_cmd_i == SET_CSR) && enable) begin
					csr <= csr | wdata;
		end else if ((csr_cmd_i == CLEAR_CSR) && enable) begin
					csr <= csr & ~wdata;
		end else begin
					csr <= update;
		end
	end
endmodule
