ShaheerSajid/ntiny/design/core/control_path/src/decoder.sv

import common_pkg::*;
import core_pkg::*;

module decoder
(
    input logic [31:0] instruction_i,
    output ctrl_bus_e ctrl_bus_o
);


rv32_opcodes_e inst_type;
br_cond_e br_cond;
load_store_width_e load_store_width;
onebit_sig_e mem_unsigned;
imm_sel_e imm_sel;
mem_op_e mem_op;
operand_e operand_a;
operand_e operand_b;
operand_e operand_c;
alu_op_e alu_op;
csr_op_e csr_op;
onebit_sig_e csr_use_immediate;
csr_reg_e csr_addr;
mul_op_e mul_op;
amo_op_e amo_op;
float_op_e float_op;
roundmode_e roundmode;
bit_op_e bit_op;
exec_result_e exec_result;
reg_add_e rs1_int;
reg_add_e rs2_int;
reg_add_e rs3_int;
reg_add_e rd_int;
reg_add_e rs1_float;
reg_add_e rs2_float;
reg_add_e rs3_float;
reg_add_e rd_float;
wb_sel_e wb_sel;

rv32_opcodes_e opcode;
logic [6:0] funct7;
logic [4:0] funct5;

assign opcode = rv32_opcodes_e'(instruction_i[6:0]);
assign funct5 = instruction_i[24:20];
assign funct7 = instruction_i[31:25];

// Decoder uses top-of-block defaults: every output is initialised at
// the start of the always_comb, then specific case branches override
// where applicable. Any unmatched opcode/funct slot falls through and
// keeps the default. This is intentional for an RV32IMAC+Zb*+Zicond
// decoder that doesn't enumerate every possible 25-bit operand combo.
// The CASEINCOMPLETE warnings from Verilator are therefore noise; the
// pragma scopes the suppression to this block only.
/* verilator lint_off CASEINCOMPLETE */
always_comb
begin

    br_cond = NO_CONDITION;
    load_store_width = NO_WIDTH;
    mem_unsigned = FALSE;
    imm_sel = NO_IMM;
    mem_op = NO_MEM_OP;
    operand_a = NO_OPERAND;
    operand_b = NO_OPERAND;
    operand_c = NO_OPERAND;
    alu_op = NO_ALU_OP;
    csr_op = NO_CSR_OP;
    csr_use_immediate = FALSE;
    csr_addr = NO_CSR_REG;
    mul_op = NO_MUL_OP;
    amo_op = NO_AMO_OP;
    float_op = NO_FP_OP;
    roundmode = RNE;
    bit_op = NO_BIT_OP;
    exec_result = NO_EX_RES;
    rs1_int = NO_REG;
    rs2_int = NO_REG;
    rs3_int = NO_REG;
    rd_int = NO_REG;
    rs1_float = NO_REG;
    rs2_float = NO_REG;
    rs3_float = NO_REG;
    rd_float = NO_REG;
    wb_sel = NO_WB;

    case(opcode)
        // --- RV32I Base Integer ---
        LUI     :   begin  
                        imm_sel = U_imm; 
                        operand_b = IMM; 
                        alu_op = PASS;
                        exec_result = ALU_RES;
                        rd_int = reg_add_e'(instruction_i[11:7]);
                        wb_sel = EXEC;
                    end
        AUIPC   :   begin 
                        imm_sel = U_imm; 
                        operand_a = PC;
                        operand_b = IMM;  
                        alu_op = ADD;
                        exec_result = ALU_RES;
                        rd_int = reg_add_e'(instruction_i[11:7]);
                        wb_sel = EXEC;
                    end
        JUMP    :   begin
                        imm_sel = J_imm;
                        rd_int = reg_add_e'(instruction_i[11:7]);
                        wb_sel = PC_WB;
                    end
        JUMP_R  :   begin
                        imm_sel = I_imm;
                        rs1_int = reg_add_e'(instruction_i[19:15]);   
                        rd_int = reg_add_e'(instruction_i[11:7]); 
                        wb_sel = PC_WB;
                    end
        BRANCH  :   begin
                        br_cond = br_cond_e'(instruction_i[14:12]);
                        imm_sel = B_imm;
                        rs1_int = reg_add_e'(instruction_i[19:15]);
                        rs2_int = reg_add_e'(instruction_i[24:20]);
                    end
        LOAD    :   begin
                        load_store_width = load_store_width_e'(instruction_i[13:12]);
                        mem_unsigned = onebit_sig_e'(instruction_i[14]);
                        imm_sel = I_imm;
                        mem_op = READ;
                        operand_a = REGISTER;
                        operand_b = IMM;
                        alu_op = ADD;
                        rs1_int = reg_add_e'(instruction_i[19:15]);
                        rd_int = reg_add_e'(instruction_i[11:7]);
                        wb_sel = MEMORY;
                    end
        STORE   :   begin
                        load_store_width = load_store_width_e'(instruction_i[13:12]);
                        imm_sel = S_imm;
                        mem_op = WRITE;
                        operand_a = REGISTER;
                        operand_b = IMM;
                        alu_op = ADD;
                        rs1_int = reg_add_e'(instruction_i[19:15]);
                        rs2_int = reg_add_e'(instruction_i[24:20]);
                    end
        // --- RV32I/Zba/Zbb Immediate & Register ALU ---
        OP_I    :   begin
                        imm_sel = I_imm;
                        operand_a = REGISTER;
                        operand_b = IMM;                           
                        case(instruction_i[14:12])
                            3'b000: alu_op = ADD;//addi
                            3'b001: case(funct7)
                                        7'b0000000: alu_op = SLL;//slli
                                        7'b0010100: bit_op = BSETI;//bseti
                                        7'b0100100: bit_op = BCLRI;//bclri
                                        7'b0110100: bit_op = BINVI;//binvi
                                        7'b0110000: case(funct5)
                                                        5'b00000: bit_op = CLZ;//clz
                                                        5'b00001: bit_op = CTZ;//ctz
                                                        5'b00010: bit_op = CPOP;//cpop
                                                        5'b00100: bit_op = SEXTB;//sext.b
                                                        5'b00101: bit_op = SEXTH;//sext.h
                                                    endcase
                                    endcase
                            3'b010: alu_op = SLT;//slti
                            3'b011: alu_op = SLTU;//sltiu
                            3'b100: alu_op = XOR;//xori
                            3'b101: casez({funct7,funct5})
                                        {7'b0000000,5'b?????}: alu_op = SRL;//srli
                                        {7'b0100000,5'b?????}: alu_op = SRA;//srai
                                        {7'b0100100,5'b?????}: bit_op = BEXTI;//bexti
                                        {7'b0110000,5'b?????}: bit_op = RORI;//rori
                                        {7'b0010100,5'b00111}: bit_op = ORCB;//orc.b
                                        {7'b0110100,5'b11000}: bit_op = REV8;//rev8
                                    endcase
                            3'b110: alu_op = OR;//ori
                            3'b111: alu_op = AND;//andi
                        endcase
                        exec_result = ALU_RES;
                        rs1_int = reg_add_e'(instruction_i[19:15]);
                        rd_int = reg_add_e'(instruction_i[11:7]);
                        wb_sel = EXEC;
                    end
        // --- RV32I/M/Zba/Zbb Register-Register ALU ---
        OP_R    :   begin
                        operand_a = REGISTER;
                        operand_b = REGISTER;
                        case(funct7)
                            7'b0000000: case(instruction_i[14:12])
                                            3'b000: alu_op = ADD;//add
                                            3'b001: alu_op = SLL;//sll
                                            3'b010: alu_op = SLT;//slt
                                            3'b011: alu_op = SLTU;//sltu
                                            3'b100: alu_op = XOR;//xor
                                            3'b101: alu_op = SRL;//srl
                                            3'b110: alu_op = OR;//or
                                            3'b111: alu_op = AND;//and
                                        endcase       
                            7'b0000001: mul_op = mul_op_e'({1'b0,instruction_i[14:12]});
                            7'b0100000: case(instruction_i[14:12])
                                            3'b000: alu_op = SUB;//sub
                                            3'b100: bit_op = XNOR;
                                            3'b101: alu_op = SRA;//sra
                                            3'b110: bit_op = ORN;
                                            3'b111: bit_op = ANDN;
                                        endcase
                            7'b0010000: case(instruction_i[14:12])
                                            3'b010: bit_op = SH1ADD;
                                            3'b100: bit_op = SH2ADD;
                                            3'b110: bit_op = SH3ADD;
                                        endcase
                            7'b0000101: case(instruction_i[14:12])
                                            3'b001: bit_op = CLMUL;
                                            3'b010: bit_op = CLMULR;
                                            3'b011: bit_op = CLMULH;
                                            3'b100: bit_op = MIN;
                                            3'b101: bit_op = MINU;
                                            3'b110: bit_op = MAX;
                                            3'b111: bit_op = MAXU;
                                        endcase
                            7'b0110000: case(instruction_i[14:12])
                                            3'b001: bit_op = ROL;
                                            3'b101: bit_op = ROR;
                                        endcase
                            7'b0000100: case(instruction_i[14:12])
                                            3'b100: bit_op = ZEXTH;
                                        endcase
                            // Zbs (reg form) — funct7s for bclr/bext/binv/bset
                            7'b0100100: case(instruction_i[14:12])
                                            3'b001: bit_op = BCLR;
                                            3'b101: bit_op = BEXT;
                                        endcase
                            7'b0110100: case(instruction_i[14:12])
                                            3'b001: bit_op = BINV;
                                        endcase
                            7'b0010100: case(instruction_i[14:12])
                                            3'b001: bit_op = BSET;
                                        endcase
                            // Zicond — czero.eqz (funct3=101) / czero.nez (funct3=111)
                            7'b0000111: case(instruction_i[14:12])
                                            3'b101: bit_op = CZERO_EQZ;
                                            3'b111: bit_op = CZERO_NEZ;
                                        endcase
                        endcase
                        exec_result = ALU_RES;
                        rs1_int = reg_add_e'(instruction_i[19:15]);
                        rs2_int = reg_add_e'(instruction_i[24:20]);
                        rd_int = reg_add_e'(instruction_i[11:7]);
                        wb_sel = EXEC;
                    end
        // --- RV32A: Atomic Memory Operations ---
        AMO     :   begin
                        operand_a = REGISTER;  // rs1 = address
                        operand_b = NO_OPERAND; // ALU: rs1 + 0 = address
                        alu_op = ADD;
                        rs1_int = reg_add_e'(instruction_i[19:15]);
                        rs2_int = reg_add_e'(instruction_i[24:20]);
                        rd_int = reg_add_e'(instruction_i[11:7]);
                        exec_result = ALU_RES;
                        wb_sel = EXEC;
                        case(instruction_i[31:27]) // funct5
                            5'b00010: amo_op = LR_W;     // LR.W
                            5'b00011: amo_op = SC_W;     // SC.W
                            5'b00001: amo_op = AMOSWAP;  // AMOSWAP.W
                            5'b00000: amo_op = AMOADD;   // AMOADD.W
                            5'b00100: amo_op = AMOXOR;   // AMOXOR.W
                            5'b01100: amo_op = AMOAND;   // AMOAND.W
                            5'b01000: amo_op = AMOOR;    // AMOOR.W
                            5'b10000: amo_op = AMOMIN;   // AMOMIN.W
                            5'b10100: amo_op = AMOMAX;   // AMOMAX.W
                            5'b11000: amo_op = AMOMINU;  // AMOMINU.W
                            5'b11100: amo_op = AMOMAXU;  // AMOMAXU.W
                            default:  amo_op = NO_AMO_OP;
                        endcase
                    end
        // --- FENCE / FENCE.I ---
        MISC_MEM:   begin
                        // FENCE (funct3=000): memory ordering — NOP on single-core write-through
                        // FENCE.I (funct3=001): instruction cache invalidation
                    end
        // --- Zicsr: CSR Access ---
        CSR     :   begin
                        imm_sel = CSR_imm;
                        csr_op = csr_op_e'({1'b0,instruction_i[13:12]});
                        csr_use_immediate = onebit_sig_e'(instruction_i[14]);
                        csr_addr = csr_reg_e'(instruction_i[31:20]);
                        exec_result = CSR_RES;
                        rs1_int = reg_add_e'(instruction_i[19:15]);
                        rd_int = reg_add_e'(instruction_i[11:7]);
                        wb_sel = EXEC;
                    end
    `ifdef FPU
        // --- RV32F: Single-Precision Floating-Point ---
        FLOAD   :   begin
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
