ShaheerSajid/ntiny/(commit log)

2024-05-18 added files from asic_nie
    [riscv.cfg]
2026-03-28 Add Verilator + RISCOF verification flow, cleanup RTL, parameterize memory map
    - Add open-source Verilator simulation with configurable timeout, pass/fail
    detection via tohost write, and VCD trace support
    - Add RISCOF compliance framework with ntiny DUT and Spike reference plugins;
    104/112 arch tests pass (8 trap-related failures expected — not yet implemented)
    - Add centralized mem_map.svh with configurable IMEM/DMEM/peripheral addresses;
    parameterize address widths throughout SoC (soc_top, interconnect, mem models)
    - Cleanup RTL: delete 50K-line fpnew_top_gate_old.v, remove commented-out CSR
    code, unify integer/float register files, normalize directory structure
    (c_ext/, interr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
    [arm_dmem_dummy.v, arm_imem_dummy.v, avalon_interconnect.sv, c_controller.sv, c_dec.sv, core2avl.sv, core_pkg.sv]
2026-03-28 Implement synchronous exception handling (ecall, ebreak, misaligned traps)
    - Extend interrupt_ctrl to handle sync exceptions with priority:
    misalign (IE stage) > ecall/ebreak (ID stage) > async interrupts
    - Add MTVAL and MSCRATCH CSRs to csr_unit
    - Fix MSTATUS to properly save/restore MPIE and MPP on trap entry/MRET
    - Add misaligned load/store detection in core_top IE stage
    - Suppress memory ops and flush IMEM on misaligned access exceptions
    - Remove $stop on ecall in tracer
    RISCOF results: 112/112 PASS (previously 104/112, 8 trap failures now fixed)
    [core_top.sv, csr_unit.sv, interrupt_ctrl.sv]
2026-03-28 Integrate PakFPU, fix F-extension compliance, unify memory map
    - Add PakFPU as submodule, wire into ALU with adapter for PakFPU
    handshake/operand conventions, restore FPU CSRs (fflags/frm/fcsr)
    - Fix fcsr flag accumulation: gate float_valid_i with !alu_stall to
    prevent stale flags leaking during multi-cycle FPU operations
    - Fix fp_f2i.sv: correct NaN/overflow/negative clamping results and
    add missing NX (inexact) flag on all non-NV paths
    - Add RISCOF F-extension verification (config_fpu.ini, ntiny_isa_fpu.yaml,
    riscof_fpu Makefile target) — all 146 F-extension tests pass
    - Unify memory map: single source of truth in mem_map.json, generator
    script produces mem_map.svh, mem_map.h,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
    [alu.sv, core_top.sv, csr_unit.sv, gen_mem_map.py, gpio_defs.h, i2c_defs.h]
2026-03-28 Software Re-Org
    [riscv.cfg]
2026-03-30 Implement RV32A extension (LR.W, SC.W, 9 AMO.W ops), RISCOF verified
    Add amo_unit.sv with 4-state FSM (IDLE→AMO_READ→AMO_WRITE→DONE) handling
    all atomic memory operations. Reservation register for LR/SC pair with
    proper invalidation on flush/SC. AMO ALU supports SWAP/ADD/XOR/AND/OR/
    MIN/MAX/MINU/MAXU. Bus mux in core_top arbitrates between core2avl and
    AMO unit.
    Fixed a forwarding-vs-stall bug: the pipeline flush logic (4'b1100 case)
    destroys IMEM forwarding sources during AMO stalls, causing alu_result to
    use stale register values. Gated misalign_amo_ie with amo_in_progress so
    the alignment check only fires on the entry cycle when forwarding is valid.
    RISCOF results: 9/9 A-extension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
    [amo_unit.sv, core_pkg.sv, core_top.sv, csr_unit.sv, decoder.sv, interrupt_ctrl.sv]
2026-03-30 Implement S/U privilege modes (Phase 2): CSRs, trap delegation, SRET, priv checks
    - Add privilege level register (M/S/U), resets to M-mode
    - Add S-mode CSRs: stvec, sscratch, sepc, scause, stval, satp (placeholder)
    - Add delegation CSRs: medeleg, mideleg, mcounteren, scounteren
    - Implement sstatus/sie/sip as masked views of mstatus/mie/mip
    - Privilege-aware trap entry (M vs S target via delegation)
    - MRET/SRET mstatus updates (MPP/SPP, MPIE/SPIE, MIE/SIE)
    - Ecall cause depends on privilege level (8=U, 9=S, 11=M)
    - S-mode interrupt qualification (SSIP/STIP/SEIP with SIE global)
    - CSR access permission check (addr[9:8] vs priv), illegal insn exception
    - MISA updated with S+U extension bits
    - R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
    [core_pkg.sv, core_top.sv, csr_unit.sv, decoder.sv, interrupt_ctrl.sv]
2026-03-30 Implement Sv32 MMU (Phase 3): ITLB, DTLB, page table walker, page faults
    - Add mmu_sv32 module: 8-entry fully-associative ITLB + DTLB with ASID/global
    - Shared PTW FSM: 2-level Sv32 walk, megapage support, alignment checks
    - Permission enforcement: R/W/X, U/S, SUM, MXR, A/D bit faults
    - SFENCE.VMA flushes both TLBs (decoder + ctrl_bus_e)
    - Translation bypass for M-mode; MPRV effective privilege for data
    - PTW arbitrates dbus for PTE reads (PTW > AMO > core priority)
    - MMU stalls integrated into pipeline stall chain (fetch + data)
    - Page fault exceptions (causes 12/13/15) wired through interrupt_ctrl
    - IBus address routed through ITLB, DBus through DTLB
    - RISCOF verified: 121 pass, 0 regressi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
    [core_pkg.sv, core_top.sv, csr_unit.sv, decoder.sv, interrupt_ctrl.sv, mmu_sv32.sv]
2026-03-30 Redesign bus/interconnect for unified RAM and cache-ready architecture
    Replace split IMEM/DMEM Harvard architecture with unified dual-port RAM
    at 0x80000000 (Linux-compatible memory map). Introduce mem_bus interface
    with req/ready/rvalid handshake, replacing IBus/DBus. Eliminate the
    4-cycle IMEM sharing FSM — dual-port RAM gives instruction fetch (port A)
    and data access (port B) simultaneous zero-contention access.
    New modules: addr_decoder (combinational address decode), periph_bridge
    (adapts mem_bus to existing peripheral interfaces), ram_dp (parameterized
    dual-port RAM). Core adapted from IBus/DBus to mem_bus.master ports.
    SoC rewritten (~300 lines, down from ~530).
    Fixes during brin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
    [addr_decoder.sv, buses.sv, c_controller.sv, core_top.sv, gen_mem_map.py, periph_bridge.sv, ram_dp.sv]
2026-04-01 Implement Sv32 MMU (Phase 4): SUM/insn-fetch fix, PTW flush, riscof summary
    MMU fixes:
    - ITLB and PTW priv check: S-mode instruction fetch from U-pages always
    faults regardless of SUM bit (SUM only applies to data accesses, per
    spec §3.1.6.3). Fixes vm_sum_set_S_mode.
    - Add i_priv_i port: separate instruction-side privilege input so ITLB
    uses fetch-time priv rather than data priv (needed for MPRV correctness).
    - Add flush_i port: abort in-flight PTW on pipeline flush/trap redirect.
    - Add PTW_L0_WAIT state: drain stale rvalid from L1 read before L0.
    - Fix ptw_l1_addr: use satp_ppn[19:0] with 12-bit shift (was wrong width).
    - Add i_fault_addr_o / d_fault_addr_o: expose PTW faulting VA (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
    [core_top.sv, csr_unit.sv, interrupt_ctrl.sv, mmu_sv32.sv, tb_soc_top.v]
2026-04-01 Fix rs2 forwarding loss during DTLB stall; improve diag tracer
    During a store DTLB miss, the IE stage stalls while forwarding sources
    (IMEM/IWB) continue advancing. When the rs2 producer completed IWB
    while the store was stuck in IE, the forwarded value was silently lost
    — FORWARD_IWB fired correctly but ie_stall=1 prevented the IE register
    from latching it. By the time the DTLB hit and the store fired, the
    forwarding source was gone and rs2_forwarded_ie held its original stale
    zero, causing the store to write 0x00000000 instead of the correct
    value. This broke vm_A_and_D_S/U_mode RISCOF tests.
    Fix: add an else branch to the IE pipeline register always_ff block
    that captures forwarded ope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
    [core_top.sv]
2026-04-02 Extract hazard_unit module from core_top; update README and Makefile
    Move all stall/flush computation, post-trap bookkeeping, refetch logic,
    CSR ret-hazard detection, and insn_valid_id tracking into a dedicated
    hazard_unit module. core_top instantiates it — behaviour is identical
    (pure refactor, verified by full RISCOF regression: 156/156 non-PMP pass).
    Update README to reflect current SoC state: A-ext, S/U privilege modes,
    Sv32 MMU, unified RAM architecture, correct peripheral addresses, and
    RISCOF pass counts. Add riscof_fpu_run Makefile target and fix stale
    RAM size comment.
    [core_top.sv, hazard_unit.sv]
2026-04-02 Define CTRL_BUS_NOP() in core_pkg; remove 33-line ctrl_bus_reset block
    Replace the per-field ctrl_bus_reset assigns in core_top with a single
    CTRL_BUS_NOP() function defined in core_pkg.sv. Adding a new field to
    ctrl_bus_e now requires only one edit in the function. RISCOF: 156/156.
    [core_pkg.sv, core_top.sv]
2026-04-02 Refactor c_controller: eliminate duplicated PC source mux
    Replace 8 address inputs (pc_sel, handler_addr, epc, dpc, branch_addr,
    branch_target_address, branch_taken, interrupt_true) with 3 signals:
    redirect_i, redirect_addr_i, interrupt_i. The internal alignment PC now
    receives the unified target from core_top's existing pc_in mux instead
    of replicating the same case statement.
    Also fixes a latent SRET bug: the old c_controller always used epc
    (MEPC) for RET redirects, even on SRET which should use sepc. Now
    uses pc_in which already distinguishes MRET vs SRET.
    RISCOF: 156/156 non-PMP pass.
    [c_controller.sv, core_top.sv]
2026-04-02 Replace priority-decoder casez blocks with shared lzc module
    Copy lzc.sv (recursive log-depth leading zero counter) from PakFPU to
    design/common/ for reuse. Replace three flat 33-case casez blocks:
    - divider.sv: dividend bit-width detection (early termination)
    - zba_zbb.sv CLZ: Zbb count-leading-zeros instruction
    - zba_zbb.sv CTZ: Zbb count-trailing-zeros (lzc on bit-reversed input)
    Eliminates ~100 lines of priority-encoder patterns, improves synthesis
    QoR (log-depth tree vs flat mux chain). RISCOF: 156/156 non-PMP pass.
    [divider.sv, lzc.sv, zba_zbb.sv]
2026-04-02 Rewrite divider with clean FSM, restoring algorithm + LZC early exit
    Replace the messy divider implementation with a clean restoring binary
    division FSM. Keeps LZC-based early termination (skips leading zeros
    in dividend — e.g., 3 cycles for small values vs 32 for worst case).
    Handles RISC-V special cases: divide-by-zero (q=-1, r=dividend) and
    signed overflow (-2^31 / -1). Same interface, drop-in replacement.
    RISCOF: 156/156 non-PMP pass (all div/divu/rem/remu tests verified).
    [divider.sv]
2026-04-02 Move misalign detection and exception gating into interrupt_ctrl
    Misalign load/store/AMO detection and insn_valid_id gating of
    ecall/ebreak/illegal were scattered in core_top as pre-computed
    wires fed to interrupt_ctrl. Now interrupt_ctrl receives raw
    pipeline signals and does detection + gating internally. Also
    outputs exception_from_ie for memory op suppression.
    Reduces core_top by ~20 lines, eliminates 6 individual exception
    port connections. RISCOF: 156/156 non-PMP pass.
    [core_top.sv, interrupt_ctrl.sv]
2026-04-02 Extract debug_ctrl module from core_top
    Move debug FSM (RUNNING/HALTED/RESUME), debug CSRs (DCSR, DPC),
    debug cause tracking, and abstract register/memory read logic into
    a dedicated debug_ctrl module. Replace 6 scattered
    (pstate==HALTED)&ar_en_i mux patterns in core_top with clean
    dbg_rf_override / dbg_mem_override signals.
    Core_top drops ~90 lines of inline debug logic, replaced by a
    single module instantiation with structured outputs.
    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
    [core_top.sv, debug_ctrl.sv]
2026-04-02 Add benchmark infrastructure and fix startup initialization
    - Dhrystone/CoreMark: add tohost_pass() for testbench completion detection
    - CoreMark: update to latest sources (zero-init fix in core_list_join.c)
    - Makefile: 64KB bench linker script, FPU-enabled march, LTO for CoreMark,
    remove -DVERILATOR (was skipping UART TX busy-wait), 10K Dhrystone iters
    - init.c: set mtvec to vector table in vectored mode (was clearing to 0),
    enable FPU (mstatus.FS = Initial)
    - uartdpi.c: add stderr + uart.log output alongside PTY
    - FPU+AMO verification test (tests/fpu_amo/)
    Baseline results (pre-BPU, no caches, 50MHz):
    Dhrystone: 1.87 DMIPS/MHz (304 cycles/iter)
    CoreMark: 3.49 CoreMark/MHz (286K c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
    [init.c, main.c, uartdpi.c]
2026-04-02 Fix AMO flush bug: insert_bubble killed AMO ops before FSM could start
    Root cause: when an AMO instruction (amoswap, amoand, amoor, etc.) was in
    the IE stage and the next instruction was a branch reading the AMO result,
    the stall_line's insert_bubble triggered ie_flush. This created a
    combinational loop: amo_stall depends on flush_i depends on ie_flush depends
    on ie_stall depends on amo_stall — Verilator settled on ie_flush=1, killing
    the AMO before the FSM could leave IDLE. The stale result from the previous
    AMO was written to rd.
    Fix: disconnect ie_flush from the AMO unit's flush input. Only genuine
    interrupts (interrupt_valid) should abort an AMO start. The AMO unit's own
    stall signal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
    [core_top.sv]
2026-04-02 Implement L1 caches (I-Cache + D-Cache), FENCE.I, and privileged arch docs
    L1 Caches:
    - icache.sv: 4KB direct-mapped, single-word entries, transparent to pipeline.
    On hit, serves from cache SRAM. On miss, forwards to RAM and fills entry.
    Always ready, 1-cycle latency (identical to bare SRAM with current backing).
    Parameterizable (ADDR_WIDTH, DATA_WIDTH, CACHE_BYTES) for RV64 transition.
    - dcache.sv: 4KB direct-mapped, write-through, single-word entries.
    Writes always go to RAM (write-through). Reads use RAM data directly
    (avoids write→read stale cache hazard). Cache fills on read misses for
    future benefit when backing store is slow (DRAM).
    - Both flushed on FENCE.I.
    - Integrate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
    [core_pkg.sv, core_top.sv, dcache.sv, decoder.sv, hazard_unit.sv, icache.sv, soc_top.sv]
2026-04-02 Add spec-compliant CLINT: mtime, mtimecmp, msip
    New CLINT module (design/uncore/clint/src/clint.sv):
    - 64-bit mtime free-running counter (increments every cycle)
    - 64-bit mtimecmp compare register (RV32: lo/hi split at 0x4000/0x4004)
    - msip register at 0x0000 (bit 0 = machine software interrupt)
    - Level-sensitive timer interrupt: MTIP = (mtime >= mtimecmp)
    - mtimecmp resets to 0xFFFF_FFFF_FFFF_FFFF (no spurious interrupt)
    - Parameterizable DATA_WIDTH for RV64 transition
    - Address map per RISC-V spec at CLINT base 0x0200_0000
    Integration:
    - CLINT timer_irq_o now drives MIP[7] (replaces timer_top.intr_o)
    - CLINT soft_irq_o now drives MIP[3] (replaces old soft_intr register)
    - timer_top kept a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
    [clint.sv, periph_bridge.sv, soc_top.sv]
2026-04-02 Replace PLIC with spec-compliant memory-mapped implementation
    Old PLIC had multiple critical issues:
    - Non-compliant register map (4 registers vs spec's full layout)
    - Gateway FSM unconditional transition (always fired)
    - Comparator tie-breaking logic reversed
    - Claim/complete via combinational pulses, not memory-mapped
    - Source count mismatch (6 declared, wrong concatenation)
    New plic_rv.sv (design/uncore/plic/src/plic_rv.sv):
    - Standard register map: priority (0x000000), pending (0x001000),
    enable (0x002000), threshold (0x200000), claim/complete (0x200004)
    - Memory-mapped claim: read returns highest-priority pending ID
    - Memory-mapped complete: write source ID to re-enable gateway
    - Per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
    [core_top.sv, plic_rv.sv, privilege_unit.sv, soc_top.sv]
2026-04-02 Boot OpenSBI on ntiny: device tree, platform port, CSR/trap fixes
    OpenSBI v1.8.1 boots successfully in simulation, printing full banner
    with platform name "ntiny", CLINT timer at 50MHz, and UART console.
    Software additions:
    - software/linux/ntiny.dts: device tree for ntiny SoC (1 hart RV32IMACSU,
    Sv32, 16MB RAM, CLINT, PLIC, UART)
    - software/linux/opensbi-platform/: OpenSBI platform port with custom UART
    console driver, ACLINT timer/IPI, PLIC irqchip
    Hardware fixes required for OpenSBI boot:
    - CSR: add csr_invalid_o output — unimplemented CSR accesses now trap as
    illegal instruction (cause 2) instead of silently returning 0. Required
    for OpenSBI's Zkr seed CSR probe loop which re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
    [core_top.sv, csr_unit.sv, hazard_unit.sv, interrupt_ctrl.sv, platform.c]
2026-04-02 OpenSBI boots and jumps to Linux kernel (kernel hits CSR trap)
    Progress: OpenSBI completes full initialization and jumps to Linux
    kernel at 0x80400000 in S-mode. Kernel immediately hits an unhandled
    CSR instruction that OpenSBI cannot emulate, printing
    "system_opcode_insn: Invalid opcode for CSR read/write instruction".
    Changes:
    - mem_map.json: bump linux RAM to 32MB (kernel Image is 21MB padded)
    - ntiny.dts: update memory to 32MB
    - ntiny_defconfig: aggressively stripped kernel config (~2.7MB actual)
    - opensbi-platform/objects.mk: add FW_PAYLOAD mode
    - initramfs.cpio.gz: 848-byte minimal init (raw syscall write+halt)
    Next: identify which CSR the kernel accesses on entry and fix/emulate.
    C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
2026-04-02 Fix csr_invalid false positive for SYSTEM-type instructions
    csr_active was matching SYSTEM opcode (ecall/ebreak/mret/sret/wfi/sfence)
    as CSR operations because SYSTEM enum != NO_CSR_OP. This caused false
    illegal-instruction traps for valid SYSTEM instructions executed from
    S-mode (e.g., the kernel's first wfi or sfence.vma).
    Fix: csr_active now only matches WRITE_CSR/SET_CSR/CLEAR_CSR.
    Also add mstatush (0x310) as read-only-zero in CSR read mux.
    Status: OpenSBI fully initializes and jumps to Linux kernel in S-mode.
    Kernel executing but no console output yet — simulation needs 100M+
    cycles for kernel early init at Verilator speeds.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
    [csr_unit.sv]
2026-04-03 HW misaligned access, TIME CSR, CLINT/PLIC read fixes, 64MB RAM
    Hardware misaligned load/store support (core2avl.sv):
    - Splits misaligned HALF/WORD accesses into two aligned bus transactions
    - FSM: IDLE → SECOND with stall output to hazard_unit
    - Combines results for loads, splits data for stores
    - Eliminates M-mode trap overhead (was millions of traps during Linux boot)
    - AMO misalignment still traps per RV spec
    TIME/TIMEH CSRs (csr_unit.sv):
    - Wire CLINT mtime[63:0] through core_top to csr_unit
    - TIME (0xC01) returns mtime[31:0], TIMEH (0xC81) returns mtime[63:32]
    - Fixes kernel jiffies spin loop (was stuck because rdtime returned 0)
    CLINT read fix (clint.sv):
    - Registered read output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
    [clint.sv, core2avl.sv, core_top.sv, csr_unit.sv, hazard_unit.sv, interrupt_ctrl.sv, main.c, plic_rv.sv]
2026-04-03 Linux boots to userspace on ntiny (U-mode, Sv32 MMU active)
    Simulation confirms Linux kernel fully boots:
    - OpenSBI initializes (M-mode), jumps to kernel (S-mode)
    - Kernel enables Sv32 MMU, sets up page tables
    - Switches to user-mode init process (priv=0, satp=804826d7, pc=0001017c)
    - Boot time: ~158M cycles (~3.2s at 50MHz)
2026-04-03 Linux v6.6 boots on ntiny with full kernel console output
    Linux kernel boot log showing complete initialization:
    - Machine model: ntiny RISC-V SoC
    - SBI v3.0 (TIME, IPI, RFENCE extensions)
    - Sv32 MMU with 60MB memory, 6 PLIC interrupts
    - 50MHz clocksource, 100 BogoMIPS
    - Console: hvc0 via SBI earlycon
    - Memory, scheduler, VFS, DMA, USB subsystems initializing
    Key config: CONFIG_HVC_RISCV_SBI=y, CONFIG_RISCV_SBI_V01=y,
    CONFIG_SERIAL_EARLYCON_RISCV_SBI=y enabled for SBI console output.
2026-04-03 Add Linux boot process and bug fix documentation
    - docs/linux_boot_process.md: detailed boot chain from reset through
    OpenSBI, kernel early init, MMU enable, to userspace. Includes memory
    maps, timing, and the stvec page-fault trick for physical→virtual
    address transition.
    - docs/linux_boot_bugs_and_fixes.md: all 12 bugs found and fixed during
    Linux bring-up, with root cause analysis, fix details, and commit refs.
    Categories: pipeline hazards, CSR issues, bus timing, missing HW features.
2026-04-03 Update bug docs: add 9 pre-Linux bugs (MMU, FPU, forwarding, c_controller)
    Total: 21 bugs found and fixed across development:
    - 9 pre-Linux (FPU flags, f2i clamping, rs2 forwarding loss during DTLB
    stall, SUM on insn fetch, PTW address width, bare-mode faults, PTW
    stale rvalid, c_controller SRET bug, mtvec cleared to 0)
    - 12 during Linux boot (AMO flush, CSR invalid, missing CSRs, post-trap
    NOP, PLIC rewrite, CLINT/PLIC reads, TIME CSR, misaligned HW, kernel
    spin loop, UART stall, log conflict, console config)
2026-04-03 Fix RV64 kernel regression, rebuild initramfs with /dev/console open
    The kernel silently flipped to CONFIG_ARCH_RV64I during olddefconfig
    when SBI console options were added. Fixed by restarting from
    rv32_defconfig. Verified clear_bss uses sw (32-bit) not sd (64-bit).
    Linux boot confirmed: kernel fully initializes and runs /init in U-mode.
    Missing /dev/console prevents init's write() from reaching UART, but
    the kernel boot is complete (all drivers initialized, timestamps advance
    to [2.9s], init process executes at priv=0 satp=804826de).
2026-04-03 Add menvcfg/senvcfg CSRs, re-enable misalign traps for debugging
    New CSRs: menvcfg (0x30A), menvcfgh (0x31A), senvcfg (0x10A),
    mconfigptr (0xF15). OpenSBI writes menvcfg to configure Sstc/Zicbom;
    these are now writable registers instead of trapping.
    Temporarily re-enabled misaligned load/store traps in interrupt_ctrl
    to diagnose bad_page memory corruption during Buildroot init startup.
    If Linux boots clean with SW emulation, the HW misalign in core2avl
    has a bug in the two-transaction store split.
    [core_pkg.sv, csr_unit.sv, interrupt_ctrl.sv]
2026-04-03 Re-enable HW misalign (not the cause), bump RAM to 128MB for Buildroot
    SW misalign emulation produced the same bad_page error, confirming
    core2avl is NOT the cause. Re-enabled HW misaligned access support.
    Bumped linux RAM to 128MB — the bad_page corruption may be caused by
    physical memory layout overlap between kernel image data and page
    struct arrays with only 64MB. 128MB gives more headroom.
    Diagnostic sim running with Buildroot rootfs on 128MB RAM.
    [interrupt_ctrl.sv]
2026-04-03 Suppress CSR writes on async interrupt, add MMU trace
2026-04-03 Add PTW fault trace, event-based crash trace for sscratch debugging
    [tb_soc_top.v]
2026-04-03 Fix PTW privilege check race: latch priv/SUM at walk start
    [mmu_sv32.sv]
2026-04-03 Fix PTW stale request after flush: suppress walk for 1 cycle post-flush
    The PTW could start a new walk from a stale d_req_i on the cycle after
    flush_i, before the IE stage pipeline registers update to NOP. This
    caused the PTW to walk a user address with S-mode privilege (trap had
    changed priv), producing a spurious privilege fault on U-pages.
    Fix: extend the PTW idle suppression for 1 cycle after flush_i using
    a flush_prev register. Also latch priv/SUM at PTW start for safety.
    [mmu_sv32.sv]
2026-04-04 Implement PMP, fix MMU stale fault, add PMP CSR stubs for RISCOF
    PMP (Physical Memory Protection):
    - New pmp_checker.sv: combinational 16-entry priority-ordered checker
    supporting OFF/TOR/NA4/NAPOT modes with lock bit enforcement
    - CSR unit: writable pmpcfg0-3 and pmpaddr0-15 with WARL mask (bits
    6:5 hardwired zero) and lock bit protection (L bit + TOR locking)
    - MMU: two PMP checker instances (instruction + data/PTW), access fault
    outputs (cause 1/5/7), PTW PMP denial handling
    - Interrupt controller: access fault priority before page faults
    - Core top: PMP CSR routing, registered insn access faults, bus write
    suppression on data PMP fault
    - RISCOF: 180/198 PASS (up from 151), 29 new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
    [core_pkg.sv, core_top.sv, csr_unit.sv, interrupt_ctrl.sv, mmu_sv32.sv, pmp_checker.sv, tb_soc_top.v]
2026-04-04 Add registered d_access_fault, wb_sel suppression for PMP faults
    - Register mmu_d_access_fault in core_top (same pattern as i_fault_r)
    for future Linux boot convergence fix
    - Suppress wb_sel at IE→IMEM wall on PMP data fault to prevent stale
    load data reaching register file
    - RISCOF: 180/198 PASS maintained
    [core_top.sv]
2026-04-04 Fix PMP pipeline: track fault to IWB, correct PTW privilege for PMP
    - Track PMP data fault through IMEM→IWB pipeline stages to suppress
    register file writeback when load access fault fires. Fixes 9 PMP
    X-only test failures (stale load data reaching register file).
    - PTW PMP checks now use the walk-initiating privilege (S/U) instead
    of M-mode. Per spec §3.7.1, implicit page table accesses use the
    privilege of the access that triggered the translation.
    - RISCOF: 189/198 PASS (up from 180)
    Remaining: 5 misalign (HW vs Spike), 2 pmp_check_on_pte, 2 pmp_check_on_pa
    [core_top.sv, mmu_sv32.sv]
2026-04-04 Register d_pmp_fault to fix Verilator UNOPTFLAT convergence
    The combinational d_pmp_fault → ptw_active_o → flush_i feedback path
    caused Verilator's UNOPTFLAT resolution to settle d_pmp_fault=0 for
    S-mode default-deny cases, breaking PMP enforcement.
    Fix: register d_pmp_fault output (1-cycle latency). The PTW FSM
    naturally waits for bus stall, so PMP denial fires in time for
    multi-cycle reads. For single-cycle reads, the PTE may be captured
    before PMP denies — this affects pmp_check_on_pte tests (2 remaining
    failures).
    Also: gate core2avl mem_op with mmu_d_access_fault to suppress
    bus transactions on PMP data faults.
    RISCOF: 191/198 PASS (5 misalign + 2 pmp_check_on_pte)
    Co-Authored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
    [core_top.sv, mmu_sv32.sv, tb_soc_top.v]
2026-04-04 Clean PMP architecture: registered faults with IE stall, no comb loops
    Eliminate all PMP-related combinational loops by fully registering the
    data PMP fault path and adding a 1-cycle IE stall to hold the faulting
    instruction until the registered trap fires:
    - pmp_checker.sv: add any_active check — when all entries are OFF,
    PMP has no effect (S/U-mode gets full access as if PMP not implemented)
    - mmu_sv32.sv: register d_pmp_fault (breaks UNOPTFLAT convergence),
    use combinational d_pmp_fault_comb only for PTW denial (no loop)
    - hazard_unit.sv: add pmp_d_fault_i to ie_stall — stalls IE 1 cycle
    so registered trap path has time to fire while instruction is in IE
    - core_top.sv: use regi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
    [core_top.sv, hazard_unit.sv, mmu_sv32.sv, pmp_checker.sv]
2026-04-04 Register data page fault path, eliminate last UNOPTFLAT loop
    Apply the same registered-fault + IE-stall architecture to data page
    faults (d_fault_o) that was used for PMP access faults:
    - mmu_sv32.sv: remove !flush_i gate from d_fault_o TLB-hit path
    (was the source of the combinational loop through trap_valid)
    - core_top.sv: register mmu_d_fault → mmu_d_fault_r for interrupt_ctrl,
    add bus suppression for page faults (dmem_port.req/we = 0)
    - hazard_unit.sv: add d_page_fault_i to ie_stall to hold the faulting
    instruction while registered trap fires
    Result: zero Verilator warnings (no UNOPTFLAT, no MISINDENT, no errors).
    All fault paths are now properly registered with pipeline stall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
    [core_top.sv, hazard_unit.sv, mmu_sv32.sv]
2026-04-04 Extend PMP and PTW to 34-bit Sv32 physical addresses
    Per RISC-V Sv32 spec, physical addresses are 34 bits even on RV32.
    The PTW and PMP checker previously truncated to 32 bits, causing
    incorrect PMP matching for page tables above 1GB.
    - pmp_checker.sv: 34-bit addr_i input, 32-bit addr_g (addr[33:2])
    matching full pmpaddr[31:0] register width
    - mmu_sv32.sv: 34-bit PTW L1/L0 address computation using full
    22-bit satp_ppn; 34-bit TLB physical address for PMP checks;
    bus address stays 32-bit (truncated from 34-bit)
    RISCOF: 191/198 PASS maintained. Remaining 7: 5 misalign (Spike
    mismatch) + 2 pmp_check_on_pte (test execution divergence in
    second phase, not PMP-related).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
    [mmu_sv32.sv, pmp_checker.sv, tb_soc_top.v]
2026-04-04 Fix page fault !flush_i gate, add priv_boot mini-OS test
    MMU: re-add !flush_i gate to d_fault_o TLB-hit path to suppress
    stale pipeline faults during trap redirect. This fixes the Linux
    kernel panic at _save_context. No comb loop: d_fault_o is registered
    in core_top (mmu_d_fault_r) before reaching interrupt_ctrl.
    Use combinational d_fault_o for interrupt_ctrl (gated by !flush_i
    for convergence), registered for bus suppression.
    Add priv_boot.S: bare-metal mini-OS test exercising M→S→U privilege
    transitions, PMP, Sv32 MMU, trap delegation, mmap/munmap simulation,
    and context save/restore. Runs in ~5000 cycles vs ~200M for Linux.
    Work in progress — debugging U-mode trap handler stack ac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
    [core_top.sv, hazard_unit.sv, mmu_sv32.sv]
2026-04-04 Register d_fault_o fully, add crash trace for Linux debug
    Remove !flush_i gate from d_fault_o — it caused a 2-state combinational
    oscillation (d_fault=1 → flush=1 → d_fault=0 → flush=0 → ...) that
    Verilator could not converge during Linux U-mode init.
    Instead: fully register d_fault_o (mmu_d_fault_r) with IE stall to
    hold the faulting instruction. The registered path has interrupt_valid
    priority clear, so stale faults during flush are discarded:
    if (interrupt_valid) mmu_d_fault_r <= 0; // stale fault cleared
    else mmu_d_fault_r <= mmu_d_fault; // real fault kept
    This eliminates the LAST combinational loop. Zero Verilator warnings.
    RISCOF: 191/198 PASS. Linux s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
    [core_top.sv, hazard_unit.sv, mmu_sv32.sv, tb_soc_top.v]
2026-04-04 Register d_fault fully, eliminate all combinational loops
    All data fault paths (page fault + PMP access fault) now use registered
    signals for interrupt_ctrl with IE stall compensation. Zero Verilator
    warnings. RISCOF: 191/198 PASS.
    Remaining issue: Linux init crashes at _save_context with store page
    fault on user tp. Root cause suspected: async_trap CSR suppression
    (commit fdbd003) drops csrw sscratch writes when timer interrupt fires
    on the same cycle, corrupting the trap entry context.
2026-04-04 Fix async_trap CSR suppression, add csrrw_test
    Remove async_trap CSR suppression — per RISC-V spec and Ibex reference,
    async interrupts fire after the current instruction commits. The
    suppression permanently dropped CSR writes when timer interrupts
    coincided with CSR instructions.
    Add csrrw_test.S: targeted test for the csrrw sscratch swap pattern
    used by Linux handle_exception. Tests basic swap, back-to-back
    forwarding, and swap-during-timer-interrupt. ALL PASS confirms the
    CSR mechanism works correctly. The Linux _save_context crash has a
    different root cause (possibly S-mode trap exit register restore).
    [core_top.sv]
2026-04-04 Fix page fault !flush_i gate, add priv_boot mini-OS test
    Critical bug fix: clear mmu_i_fault_r on pipeline flush (including
    SRET/MRET). A stale registered instruction page fault from the
    pre-SRET fetch path would fire on the same cycle as SRET, overwriting
    sepc with the fault address (0) and sending the PC to address 0
    instead of the sepc target. This was the root cause of the Linux
    _save_context crash.
    The fix: clear i_fault_r on the full flush condition (interrupt_valid
    OR branch OR ret_valid), not just interrupt_valid. This ensures stale
    instruction faults from the old execution path are discarded when the
    PC redirects.
    Also: remove async_trap CSR suppression (let CSR writes complete
    be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
    [core_top.sv]
2026-04-04 Add Zkr seed CSR (xoshiro128** PRNG), fix all registered fault clears
    Zkr entropy source:
    - New rng_seed.sv: xoshiro128** PRNG (128-bit state, period 2^128-1)
    - CSR unit: SEED CSR (0x015) returns {OPST_ES16, 14'b0, entropy[15:0]}
    - Advances on each CSR read, optional reseed via CSR write
    - OpenSBI will detect Zkr as present, Linux gets /dev/urandom entropy
    Fault clearing fix:
    - ALL registered faults (i_fault_r, d_fault_r, i_access_fault_r,
    d_access_fault_r) now clear on flush_any (trap + branch + ret)
    - Previously only cleared on interrupt_valid, missing branch/ret cases
    - Prevents stale faults from corrupting trap entry after PC redirect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
    [core_pkg.sv, core_top.sv, csr_unit.sv, rng_seed.sv]
2026-04-04 Add priv_boot_timer test (ALL PASS), QEMU comparison data
    priv_boot_timer: exercises timer interrupt during U-mode with full
    M→S→U→timer→M→S privilege chain. ALL PASS confirms basic trap
    mechanism works.
    QEMU comparison: same kernel+rootfs boots to login on QEMU virt
    with 13141 traps including demand paging at 0x0011fxxx (same TLS
    region as our crash). QEMU handles these correctly. Our hardware
    delivers a nested fault during _save_context before sscratch is
    zeroed (line 73 of entry.S). The registered d_fault_r fires 1 cycle
    after PTW completes, causing a spurious trap during context save.
    Root cause confirmed: PTW page fault delivery via mmu_d_fault_r
    delays the trap by 1 cycle,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
2026-04-04 Fix SRET + stale i_fault_r race: clear during ITLB-miss stall
    Root cause of Linux _save_context crash: after SRET, the old S-mode
    fetch path generates a stale mmu_i_fault that gets registered as
    i_fault_r. During the ITLB-miss stall (PTW walking for the U-mode
    target address), if_id_stall=1 prevents flush_any from clearing
    i_fault_r. The stale fault survives for 6+ cycles and fires when
    the stall resolves, overwriting sepc with address 0.
    Fix: add sret_active to i_fault_r clearing condition. SRET (not MRET)
    clears i_fault_r regardless of if_id_stall, because S-mode fetch
    generates stale faults during the privilege transition that MRET
    doesn't (M-mode has no ITLB translation).
    Also add save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
    [core_top.sv]
2026-04-04 Add trap_sequencer: centralized fault registration FSM
    Replace scattered registered-fault logic in core_top with a dedicated
    trap_sequencer module that manages MMU fault lifecycle through pipeline
    redirects. This is the clean architectural solution to the SRET + stale
    i_fault_r race that crashed Linux _save_context.
    The core problem: after SRET, the old S-mode fetch path generates a
    stale mmu_i_fault that gets registered as i_fault_r. During the
    ITLB-miss stall (PTW walking for the U-mode target), if_id_stall
    prevents flush_any from clearing i_fault_r. The stale fault survives
    6+ cycles and fires on the wrong instruction, overwriting sepc.
    The FSM solution (trap_sequencer.sv):
    - IDLE: faul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
    [core_top.sv, tb_soc_top.v, trap_sequencer.sv]
2026-04-05 Add trap_sequencer: centralized fault registration FSM
    New trap_sequencer.sv: replaces scattered registered-fault logic in
    core_top with a clean FSM. Manages i_fault_r lifecycle through SRET
    with an SRET_WAIT state that suppresses stale S-mode fetch faults
    during ITLB-miss stalls.
    Fix: only suppress i_fault during SRET_WAIT while mmu_i_stall is
    active (PTW still walking). When PTW completes (stall drops), stop
    suppressing so real page faults (demand paging) can propagate.
    Update save_context_test.S: intentionally leave U-mode page unmapped
    to test demand-paging exec page fault through _save_context — this
    is the exact Linux init scenario.
    RISCOF: 191/198 PASS. save_context test needs ve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
    [trap_sequencer.sv]
2026-04-05 Add trap_sequencer FSM, run scripts, disable traces by default
    - trap_sequencer.sv: centralized fault registration FSM (IDLE/SRET_WAIT)
    replaces scattered registered-fault logic in core_top
    - run_linux.sh, run_save_context.sh, run_riscof.sh: convenience scripts
    - Crash trace and MMU trace gated by DV_CRASH_TRACE/DV_MMU_TRACE defines
    - RISCOF: 191/198 PASS maintained
    Linux still stuck at SRET to U-mode — root cause identified:
    registered d_fault_r from kernel stack loads during ret_from_exception
    overwrites sepc between csrw and sret (30+ instructions window).
    Need proper RESTORE_WINDOW state in trap_sequencer.
    [tb_soc_top.v, trap_sequencer.sv]
2026-04-05 Suppress stale ITLB-hit i_faults after flush until fetch resolves
    After a pipeline redirect (SRET/branch/trap), the old ITLB entry may
    still match the old address and generate spurious instruction page
    faults. These stale faults overwrite sepc, corrupting the return
    address for SRET (root cause of Linux _save_context crash).
    Fix: suppress TLB-hit i_fault path (NOT PTW_FAULT path) while the
    instruction fetch is stalled after a flush. The suppression clears
    automatically when the ITLB resolves (stall drops). Real demand-paging
    faults go through PTW_FAULT which is NOT suppressed.
    This is flexible — no fixed cycle count, adapts to PTW latency.
    RISCOF: 191/198 PASS maintained.
    Co-Authored-B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
    [mmu_sv32.sv]
2026-04-05 Revert flush_ifault_suppress (broke OpenSBI), fix Makefile DV_DIAG_TRACE
    The flush_ifault_suppress in mmu_sv32.sv blocked legitimate instruction
    faults during OpenSBI CSR probing, causing sbi_hart_hang.
    Reverted to the 7d0b33c MMU state (just !flush_i gate on TLB-hit path).
    Also removed +define+DV_DIAG_TRACE from RISCOF Makefile build.
    Known issue: Linux stuck at SRET to U-mode (c0003076) — confirmed with
    both ilp32d busybox AND ilp32 static mini-init. The PC never latches
    sepc during ITLB-miss stalls. Needs architectural rethink of
    c_controller + program_counter + trap_sequencer interaction.
    RISCOF: 191/198 PASS. OpenSBI boots. Linux reaches "Run /init".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
    [mmu_sv32.sv]
2026-04-07 Add riscv-dv directed tests and riscof harness Makefile
    Move the verification harness pieces that aren't tied to the in-flight
    SRET/Linux-boot debug into git so they don't get lost on the next branch
    switch:
    - verification/riscv-dv/: Makefile, run script, link script, core setting,
    testlist, compare_trace.py, plus four directed assembly tests targeting
    hazards we've found in the SRET path: sret_itlb_miss, csr_branch_hazard,
    csr_branch_zero, trap_csr_branch.
    - verification/riscof/Makefile: top-level harness that wraps the existing
    riscof config.ini + ntiny/spike platform dirs (already tracked) so the
    whole regression can be invoked with `make -C verification/riscof run`.
    - .gitigno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
2026-04-07 Replace per-trace shims with unified VCD trigger machinery in testbench
    The testbench had three separate file-based trace mechanisms — `crash_trace`,
    `mmu_trace`, and `diag_tracer.vh` — each with their own arming logic, fopen
    calls, and per-cycle dump fwrites. They worked but had three problems: the
    log files balloon to multiple GB on long Linux runs, the SystemVerilog
    fopen/fwrite has no triggered windowing (you get every cycle from boot), and
    adding a new signal to trace meant editing tb_soc_top.v in three places.
    Replace all of them with a single VCD-trigger interface in main.cpp:
    --trace Always-on VCD (whole simulation)
    --vcd-start-cycle <N> Open VCD a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
    [main.cpp, tb_soc_top.v]
2026-04-07 Move verification harness wiring out of flows/simulation/Makefile
    flows/simulation/Makefile had a 100-line block of inline RISCOF targets
    (verilator_build_riscof, riscof, riscof_summary, riscof_run, riscof_fpu_run,
    riscof_testlist) that hardcoded paths to verification/riscof and the riscof
    venv. Now that verification/riscof has its own Makefile (committed
    separately), all of those become a thin three-line wrapper that just
    forwards to `make -C ../../verification/riscof <target>`. Same for
    riscv-dv.
    Add top-level convenience targets in the root Makefile so the user can run
    `make riscof`, `make riscof_fpu`, `make dv`, `make dv_test TEST=foo`,
    `make dv_list`, `make riscof_summary`, `make clean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
2026-04-07 Linux kernel build: rv32imac/rv32ima defconfigs, fix bug #12 recurrence, no-C build script
    ntiny_defconfig was missing two things that bit us as silent boot failures:
    1. RISCV_SBI_V01 wasn't explicitly enabled. Both HVC_RISCV_SBI and
    SERIAL_EARLYCON_RISCV_SBI depend on it (it's RISCV_SBI v0.1 legacy
    putchar). It defaults to N, and the defconfig snippet didn't set it,
    so olddefconfig silently dropped HVC_RISCV_SBI/EARLYCON_RISCV_SBI and
    the kernel booted with no console driver — recurrence of bug #12.
    The previous build "worked" only because of stale .config state.
    Add CONFIG_RISCV_SBI_V01=y + CONFIG_SERIAL_EARLYCON_RISCV_SBI=y.
    2. CONFIG_INITRAMFS_SOURCE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
2026-04-07 docs: fetch revamp plan + bit extensions implementation plan
    Two planning documents that don't ship code, just direction:
    * docs/fetch_revamp_plan.md (1006 lines, 12 sections):
    Comprehensive plan to revamp the fetch / c_controller / interrupt /
    stall subsystems. Identifies the common thread behind bugs 14 and 15
    (the IF stage has no explicit "fetch in flight" concept, every fix is
    a per-source bypass mux), proposes a Redirect Arbiter + Fetch Issue
    Unit + Fetch Buffer + Compressed Aligner architecture, gives full
    module specs with SystemVerilog interfaces, sequence diagrams for
    cold-ITLB SRET / fault-during-fetch / warm MRET, a 17-test unit + 8
    integration test plan, a 6-phas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
2026-04-07 core: fix Linux SRET trap-entry bug stack (bugs 13-17), bug 18 deferred to revamp
    Five layered bugs in the privilege-transition / trap-entry path were
    unburied during Linux boot debugging. All five fixed; bug 18 (the IE wall
    latching stale decode at trap entry) is structurally tied to the no-IF/ID-
    register architecture and is deferred to the fetch revamp.
    Bug 13: privilege_unit dropped priv mid-DTLB walk
    ret_fire/sret_fire were not gated by !ie_stall. SRET committed its CSR
    side effects on the same cycle a preceding store was still walking the
    PTW; the walk completed several cycles later and re-checked permissions
    against the new (post-SRET) priv level, faulting on kernel-only page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
    [c_controller.sv, core_top.sv, hazard_unit.sv, privilege_unit.sv, trap_sequencer.sv]
2026-04-07 fetch revamp Phase 1: parallel redirect_arbiter with SVA cross-check
    First step of the fetch / c_controller / interrupt / stall revamp
    (docs/fetch_revamp_plan.md). Adds the redirect arbiter as a parallel
    observation-only module — no functional path consumes its outputs yet.
    Two SVA assertions in core_top.sv cross-check the arbiter's outputs
    against the existing pc_sel/pc_in mux on every cycle, so any divergence
    between the new and legacy redirect logic surfaces immediately under
    RISCOF + Linux.
    New module
    design/core/fetch/src/redirect_arbiter.sv — combinational priority
    encoder over (debug_resume, trap_valid, branch_taken, ret_valid) with
    the corresponding target muxed from (dpc,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
    [core_pkg.sv, core_top.sv, redirect_arbiter.sv]
2026-04-07 fetch revamp Phase 2.1: parallel fetch_buffer snoop with no-overflow SVA
    Second step of the fetch / c_controller / interrupt / stall revamp
    (docs/fetch_revamp_plan.md §4.3 / §9 Phase 2). Adds fetch_pkg + the
    fetch_buffer module as a parallel observation-only snoop on the existing
    imem_port traffic. The buffer outputs are not consumed by any functional
    path; an SVA assertion verifies that the snoop drive (push every rvalid,
    pop every rvalid) never overflows the buffer.
    Phase 2.2 will add the compressed_aligner on top of this buffer with a
    cross-check assertion against the legacy c_controller.instruction_o.
    Phase 3 will switch the decoder over.
    New files
    design/core/fetch/src/fetch_pkg.s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
    [core_top.sv, fetch_buffer.sv, fetch_pkg.sv]
2026-04-07 fetch revamp Phase 2.2: parallel compressed_aligner snoop (additive only)
    Adds the compressed_aligner module on top of the Phase 2.1 fetch_buffer
    snoop. Both modules are observation-only — they read imem_port traffic
    but no functional path consumes their outputs. The legacy c_controller
    still drives the decoder. Validation strategy is "additive then swap":
    this commit just proves the new modules compile, simulate, and exercise
    their state machines without perturbing the legacy. Phase 3 swaps the
    decoder source over and uses RISCOF signature comparison against the
    spike reference as the correctness gate.
    design/core/fetch/src/compressed_aligner.sv — combinational+1bit-state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
    [compressed_aligner.sv, core_top.sv]
2026-04-08 fetch revamp Phase 3: switch decoder to aligner + move branch resolution to IE
    This is the live-switchover commit for the fetch revamp. The decoder
    now reads from the new compressed_aligner instead of the legacy
    c_controller, and branch resolution moves from the ID stage to the IE
    stage. Together these eliminate the architectural quirks that produced
    bugs 14, 15, and 18, at the cost of +1 cycle of branch penalty (1→2)
    that BPU work will eventually amortize.
    Smoke test status (sampled, 67 tests across all ISA categories):
    PASS: 55 (all RVC, all branches/jumps, all AMO, all M, all
    arithmetic, all aligned loads/stores, jal/jalr/ret)
    FAIL: 3 (ecall, ebreak, pmp-CF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
    [compressed_aligner.sv, core_top.sv, hazard_unit.sv, stall_line.sv]
2026-04-08 fetch revamp Phase 3.1: forward load result via imem_forwarded_data
    Single-line fix on top of Phase 3 (39b4ca4): the IMEM-stage forwarding
    mux didn't have a case for `wb_sel = MEMORY` (loads), defaulting to 0.
    The legacy was masking this by using stall_line's
    `(lu_ie | br_true) & stall_condition_ie` bubble to delay any consumer
    until the load reached IWB, where `write_back_data` correctly handles
    MEMORY → readdata_iwb.
    Phase 3 removed those stall_line bubbles when moving branch resolution
    to the IE stage, which exposed the missing forwarding path. The
    `lw a0, ...; jr a0` and `lw t2, ...; beqz t2, ...` patterns inside the
    RISCOF trap handlers were reading 0 instead of the load result, caus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
    [core_top.sv]
2026-04-08 fetch revamp Phase 3.2: gate redirect bypass with csr_ret_hazard
    The PC-stall bypass `(interrupt_valid | ret_pulse | arb_redirect_valid)
    ? 0 : fetch_producer_stall` would fire on the same cycle that mret/sret
    in ID was waiting for a csrrw mepc/sepc in IE to commit. csr_ret_hazard
    already extends if_id_stall to hold the mret an extra cycle, but the
    bypass overrode that on the program_counter.stall_i path, so pc_out
    latched pc_in = OLD epc — the mret jumped to the previous trap's epc.
    Same race on imem_port.req — the bypass issued a fetch for the OLD
    epc target before mepc could update.
    Fix: AND `~csr_ret_hazard` into both bypass conditions. The mret holds
    in ID for one extra cycle; on t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
    [core_top.sv]
2026-04-08 riscof: add RISCOF_SKIP env var to filter test categories
    Both spike and ntiny plugins now honour `RISCOF_SKIP=substr1,substr2,...`,
    silently dropping any test whose path contains one of the substrings.
    The spike side is filtered too so the summary target doesn't mark every
    skipped test as MISSING (DUT sig=N, REF sig=Y), which would mask real
    failures in the categories we DO care about.
    Used during the fetch revamp bringup to validate the suite category by
    category. With `RISCOF_SKIP=pmp32,vm_sv32` the current `fetch-revamp`
    branch passes 116/121 (the 5 fails are misalign-l*/s*, known false
    negatives where spec allows either HW or M-mode trap behaviour).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
2026-04-08 fetch revamp Phase 3.3: gate ret_valid_o by csr_ret_hazard
    Phase 3.2 fixed the program_counter / imem.req bypass during the
    mret-after-csrrw-mepc hazard, but missed the upstream root: ret_valid_o
    itself was still firing in the same cycle the mret was supposed to be
    held in ID by csr_ret_hazard. The chain was:
    cycle K csrrw mepc in IE, mret in ID, csr_ret_hazard=1
    ret_valid=1 -> redirect_arbiter fires -> aligner flush
    ret_fire=0 (correctly gated) -> priv_level NOT updated
    if_id_stall=1 holds IE wall, but the aligner flush has
    already evicted the mret from the head
    cycle K+1 csr_ret_hazard=0 but the mret is gone -- side effects (priv,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
    [privilege_unit.sv]
2026-04-08 fetch revamp Phase 3.4: gate redirect bypass with mmu_i_stall
    Phase 3 added an `arb_redirect_valid` bypass to imem_port.req so a
    redirect could push its target out to the bus even when the producer
    side was back-pressured (legacy did NOT have this — it just used
    `refetch_after_trap | (~if_id_stall & ~c_stall)`). The bypass missed
    mmu_i_stall though.
    Impact: when an mret/trap target lives on a virtually-mapped page
    whose ITLB entry is missing (e.g. immediately after sfence.vma), the
    MMU's i_paddr_o defaults to {PPN=0, offset} on the cycle of the miss
    while it kicks off a PTW. The unconditional bypass forces
    imem_port.req=1 with that bogus PA, the SRAM happily returns whatever
    lives at offs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
    [core_top.sv]
2026-04-09 trap revamp Phase 4.1+4.2: tag pipeline + add wb_trap_unit (parallel)
    Phase 4 architectural rework: move trap/interrupt/xRET/dret commitment
    to the IWB stage, eliminating the entire family of mret-after-csrrw
    and xRET-vs-PTW races we hit in Phase 3.2/3.3/3.4. Detection still
    happens at the natural stage; commitment is deferred to IWB so:
    * any older csrrw mepc/sepc has already committed when mret reads it
    * IF/ID/IE/IMEM are flushed atomically as a single redirect — no
    pc_out / pc_in / inflight_vaddr_q race
    * the csr_ret_hazard guard, ret_pulse, and ret_side_effects_done
    one-shots can all be deleted
    This commit is the additive prep work, no behavior change yet:
    * core_pkg: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
    [core_pkg.sv, core_top.sv, csr_unit.sv, decoder.sv, interrupt_ctrl.sv, wb_trap_unit.sv]
2026-04-09 trap revamp Phase 4.3: cut xRET over to wb_trap_unit (IWB-stage commit)
    Move mret/sret resolution from the ID stage to IWB. The carrier
    instruction propagates through the pipeline normally with its WB_XRET
    tag (Phase 4.1); when it reaches IWB, wb_trap_unit (Phase 4.2) reads
    the freshly-committed mepc/sepc/mstatus, fires its commit pulses
    (redirect_valid, csr_unit ret_i/sret_i), and triggers a 4-stage flush
    of IF/ID/IE/IMEM. The carrier itself retires its CSR side effects on
    the same cycle.
    Why this is the right architecture: by the time the xret reaches IWB,
    any older `csrrw mepc/sepc` has already committed (it was older in
    program order), so the read is always fresh. The whole class of
    mre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
2026-04-09 trap revamp Phase 4.6: delete dead xRET ID-stage logic
    Phase 4.3 moved xRET commit to IWB via wb_trap_unit. The legacy
    ID-stage signals (csr_ret_hazard / ret_valid / ret_fire / sret_fire /
    ret_side_effects_done / mmu_priv override) became dead but were left
    in place to keep that commit small. This pass deletes them.
    * hazard_unit: drop the 6 csr_ret_hazard input ports, the
    csr_ret_hazard_o output, and the csr_ret_hazard assign + lint stub.
    csr_ret_hazard is gone from if_id_stall_o (already gone in 4.3).
    * privilege_unit: reduced to a pure illegal-instruction detector.
    Deleted clk_i / reset_i / insn_valid_id_i / csr_ret_hazard_i /
    ie_stall_i / interrupt_valid_i inputs. Deleted ret_v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
    [core_top.sv, hazard_unit.sv, privilege_unit.sv]
2026-04-09 fetch revamp Phase 4.7: pending_target barrier on deferred redirects
    When a redirect (branch/xRET/trap/debug) lands on a virtually-mapped
    target whose ITLB entry is missing, the producer-side bus request was
    correctly suppressed by Phase 3.4's `~mmu_i_stall` guard, but the off-
    by-one between pc_out and pc_in still leaked the wrong VA into the
    MMU on the cycles after the redirect — `pc_in = pc_out + 4` advances
    past the redirect target the cycle after pc_out latches it, and the
    MMU's combinational `itlb_hit` is computed against the live i_vaddr_i.
    After the original PTW completes the MMU then walks for `target+4`
    (the wrong-path sequential fetch), and for vm_VA_all_ones this wraps
    to VA 0x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
    [core_top.sv]
2026-04-09 riscof: align ntiny linker layout to spike's reference
    ntiny's RISCOF linker script differed from spike's reference in a
    subtle but important way: spike puts a real .tohost section in RAM
    between .text.init and .data, occupying one 4KB page. ntiny puts
    .tohost at a fixed bus-monitored address outside RAM (0x0F000000),
    so the slot wasn't reserved and .data ended up at .text.init_end +
    1 page — exactly 0x1000 LOWER than spike's binary.
    Visible effect: every test that uses an absolute PC value through
    AUIPC + signature writes of EPCs ended up walking divergent code
    paths against the spike reference, even when the tests were
    otherwise identical. compare_trace.py reported GPR mismatches at
    ins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
    [gen_mem_map.py]
2026-04-09 fetch revamp Phase 4.8: route i-side comb faults through fetch_buffer
    Wrong-path bug fix for the PMP cluster: an unconditional jump (e.g.
    `j 0x8000078c` at PC 0x80000764) issues a sequential prefetch for PC+4
    one cycle after the JAL fetch. If PC+4 lives in a no-perm PMP region,
    mmu_i_access_fault_o (a combinational signal) fires the same cycle.
    Two cycles later, before the JAL has reached IE, the legacy path
    latches the fault and interrupt_ctrl fires a sync trap with
    mepc=PC+4. The JAL never commits — it gets clobbered by the trap's
    IE flush — so the test sees one EXTRA trap that spike never sees
    (spike is non-speculative).
    Fix: latch the comb i-side fault into `inflight_i_fault_q` at i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
    [core_top.sv, mmu_sv32.sv]
2026-04-10 fetch revamp Phase 4.9: xret_fetch_ctrl FSM for post-mret/sret priv settling
    Moving xRET commit from ID to WB (Phase 4.3) compressed the privilege
    switch into a single-cycle wb_xret_fire pulse. On that cycle the CSR
    priv_level hasn't clocked yet, so the combinational fetch issues at
    M-mode privilege — disabling Sv32 translation and sending the raw VA
    as PA. The legacy dev branch avoided this with a per-cycle mmu_priv
    override active while mret sat in ID; that approach doesn't survive
    the WB move because combinational overrides on a 1-cycle pulse create
    races with ITLB stall, PTW abort, and fault paths.
    Fix: a 3-state registered FSM (IDLE → XRET_WAIT → XRET_FETCH → IDLE)
    that seque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
    [core_top.sv]
2026-04-10 fetch revamp Phase 4.9a: extend xret FSM with XRET_DRAIN + wrong-path suppression
    Extend the xret_fetch_ctrl FSM from 3 states to 4:
    IDLE → XRET_DRAIN → XRET_WAIT → XRET_FETCH → IDLE
    XRET_DRAIN is entered the cycle after the aligner emits an mret/sret
    (detected by xret_at_decode). While draining:
    - fetch_flush clears the buffer (wrong-path entries behind the mret)
    - i_buf_fault_squash suppresses buffer-routed faults
    - IE register wall captures NOP (wrong-path instructions don't execute)
    - imem.req is suppressed (no new fetches at stale priv)
    The same-cycle xret_at_decode signal is added to both the fault squash
    gate and the fetch_flush so the wrong-path entry that become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
    [core_top.sv]
2026-04-10 fetch revamp Phase 4.9b: clear stale inflight fault on redirect + VCD root cause
    Add arb_redirect_valid clear for inflight_i_fault_q: when a redirect
    fires but the handler fetch is blocked by mmu_i_stall (ITLB miss at
    old privilege), the stale fault flag from the previous speculative
    fetch persists and contaminates the next fb_push — creating a spurious
    2nd trap at M-mode privilege.
    The clear fires on (arb_redirect_valid && !imem_port.req) so it
    doesn't suppress a NEW fault from a redirect that also issues a fetch.
    VCD analysis confirmed the precise root cause of pmp_check_on_pa:
    1. Cycle K: imem.req for PMP-faulting VA. inflight_i_fault_q ← 1
    2. Cycle K+1: fb_push with fault=1 (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
    [core_top.sv]
2026-04-10 fetch revamp Phase 4.10: suppress trap-cycle handler fetch for stale-priv PMP fix
    Root cause (VCD-confirmed): on the trap-redirect cycle, imem_port.req
    fires simultaneously for the handler fetch via (arb_redirect_valid &
    ~mmu_i_stall). The PMP check uses the pre-trap priv_level (S, not yet
    updated to M by csr_unit), so the handler at PA 0x80000e00 triggers a
    spurious mmu_i_access_fault. This re-captures inflight_i_fault_q=1,
    blocking the redirect clear (guarded by !imem_port.req). The stale
    fault rides fb_push into the buffer → aligner fires → 2nd spurious
    trap with MPP=M instead of S → handler takes wrong code path → test
    aborts prematurely (pmp_check_on_pa_S/U_mode).
    Fix:
    1. Gat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
    [core_top.sv, fetch_buffer.sv]
2026-04-10 fetch revamp Phase 4.10b: fix async interrupt mepc when fetch buffer is between entries
    When the fetch buffer drains (aligner gap cycle), pc_id drops to 0
    while the previous instruction has already moved to IE. If an async
    interrupt (timer/software/external) fires on that exact gap cycle,
    mepc was saved as 0 — the handler returns to address 0 and crashes.
    Root cause: interrupt_ctrl used pc_id_i (aligner output) for async
    interrupt epc. On buffer gap cycles, pc_id_i = 0 (aligner default
    when head_valid = 0). The oldest in-flight instruction is in IE at
    pc_ie_i, not ID.
    - Add pc_out_i port to interrupt_ctrl for future use
    - Use pc_ie_i as fallback when pc_id_i = 0 for async interr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
    [core_top.sv, interrupt_ctrl.sv]
2026-04-10 fetch revamp Phase 4.10c: XRET_ADVANCE state to prevent duplicate fetch push
    Root cause (VCD-confirmed): during XRET_FETCH, pc_out is held at
    xret_target by xret_hold_pc. The normal fetch path fires a second
    req at the same address (buffer empty, fetch_stall not yet active).
    Both reqs produce rvalid → two identical buffer entries with the
    same word/vaddr → the compressed aligner assembles a straddled 32-bit
    instruction using head[15:0] instead of next[15:0] → wrong JAL target
    (Linux kernel entry JAL at 0x80400002 jumps to 0x804d15a6 instead of
    0x80401084 → kernel executes garbage → BUG/crash).
    Fix: add XRET_ADVANCE state between XRET_FETCH and XRET_IDLE. During
    ADVANCE (1 cycle),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
    [core_top.sv]
2026-04-10 fetch revamp Phase 4.10d: suppress ID-stage exceptions in branch shadow
    Root cause (VCD-confirmed): when a taken branch in IE has a sync
    exception (ebreak/ecall/illegal) on its speculative fall-through
    instruction in ID, the exception fires before the branch redirect
    can flush it. The redirect arbiter prioritises trap > branch, so
    the trap wins and vectors through stvec instead of the branch target.
    Linux setup_vm has `c.beqz a4, +4; c.ebreak` (BUG_ON alignment
    check). The c.beqz is taken (alignment OK) but the c.ebreak in ID
    fires cause=3 before the branch resolves → kernel restarts at stvec
    (uninitialised) → crash.
    Fix: gate ID-stage sync exceptions (ecall_valid, ebreak_valid,
    illega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
    [core_top.sv, interrupt_ctrl.sv]
2026-04-10 mmu: implement hardware Svadu (A/D bit updates) in Sv32 PTW
    The RISC-V Svadu extension allows the page table walker to
    atomically set the Accessed (A) and Dirty (D) bits in page table
    entries, avoiding page faults that the kernel would otherwise need
    to handle in software.
    Without Svadu, any access to a page with A=0 (or store with D=0)
    causes a page fault. Linux's trap entry code (_save_context) stores
    to the thread_info page — if that page's PTE has D=0, the store
    faults, and the trap handler itself faults trying to save context,
    creating an infinite page-fault loop that hangs the kernel.
    Implementation:
    - Add PTW_UPDATE_AD state to the PTW FSM (between PTW_FILL and
    PTW_IDLE). Wh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
    [core_top.sv, mmu_sv32.sv]
2026-04-11 fetch revamp Phase 4.13: fb_push dedup + straddled-instr support for deferred-redirect targets
    Two-part fix for the duplicate-fetch bug that caused 64-byte sp drift in
    setup_arch and crashed Linux on its return.
    Root cause: while pending_target_v_q held pc_out at a deferred-redirect
    target (PTW miss on the redirect target VA), the producer kept issuing
    imem_port.req every cycle with i_vaddr=pending_target_q. Each duplicate
    rvalid pushed an identical entry into the fetch_buffer; the aligner emitted
    the same compressed instructions twice; IE re-ran them with rs1 forwarded
    from the first commit. _printk's c.addi16sp sp,-64 then committed twice
    per deferred redirect, leaking 64 bytes of stack a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
    [core_top.sv]
2026-04-11 sim: add debug.log + TRAP/XRET monitor + PC sampler
    Adds a separate debug.log file (the existing uart.log stays clean for
    console output) and three monitors that write to it:
    - TRAP: every interrupt_valid cycle, dumps cause/epc/tval/satp/priv
    - XRET: every wb_xret_fire cycle, dumps pc/priv/satp
    - PC sampler: every 1M cycles, dumps pc_out + a peek at the FDT magic
    word so we can confirm the device tree wasn't trampled
    Used during the Linux boot debug to localize sp drift, deferred-redirect
    duplicate fetches, and the paging_init straddled-instruction deadlock.
    [tb_soc_top.v]
2026-04-11 fetch revamp Phase 4.13c: extend pc_for_async fallback to pc_out for post-xret window
    When an async interrupt (timer/software/external) fires the cycle right
    after wb_xret_fire commits, both pc_id_i and pc_ie_i are 0 — the pipeline
    is freshly starting to fetch the post-xret target and no instruction has
    reached IE yet. Phase 4.10b's fix `pc_for_async = pc_id_i || pc_ie_i`
    landed mepc=0 in this window, the M-mode handler returned to PC=0, and
    later in S-mode we got a NULL fetch page fault and oops.
    The xret target IS already latched into program_counter on the xret
    commit cycle, so pc_out_i holds it. Extend the fallback chain:
    pc_for_async = pc_id_i != 0 ? pc_id_i :
    pc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
    [interrupt_ctrl.sv]
2026-04-11 sim: add narrow PUTC trace for sbi_putc debugging
    Captures pc_id/pc_ie/pc_iwb, the rf write commit, and the fb_head/next
    vaddrs whenever the pipeline is near sbi_putc (c0150e44..c0150e5c).
    Used to confirm Phase 4.13c (post-xret async-interrupt mepc=0 bug):
    the auipc at c0150e4e correctly wrote ra=c0004e4e, jalr at c0150e52
    correctly jumped to c0005002 — proving the crash was a fetched-PC=0
    issue, not a wrong-target jalr. Kept for future regression debugging.
    [tb_soc_top.v]
2026-04-11 software/linux: rebuild minimal initramfs with /dev/console + sustaining init
    The previous initramfs_mini.cpio.gz was missing a /dev/console device
    node — only an empty /dev directory. The kernel printed
    "Warning: unable to open an initial console", exec'd /init with stdin/
    stdout/stderr unconnected, the init binary's printf went nowhere, init
    tried exec /bin/sh which doesn't exist, exited with status 1, and the
    kernel panicked ("Attempted to kill init!").
    Replace it with a proper minimal initramfs:
    initramfs_src/init.c raw RV32 syscalls (no libc), 1504 bytes static.
    Prints a banner and loops forever via nanosleep
    so the kernel never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
    [init.c]
2026-04-11 linux: clean software/linux folder, add Makefile, minimize kernel patches
    Now that fetch-revamp Phase 4.13/4.13b/4.13c boots Linux to a busybox
    shell, prune everything that was only useful while bringing it up.
    software/linux/ now contains exactly what's needed for a fresh clone
    to build and run Linux end-to-end:
    Makefile one-command automation:
    make prepare → clones Linux v6.6 + OpenSBI
    v1.8 if missing, copies the
    ntiny DTS into the kernel
    tree, applies the kernel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
    [tb_soc_top.v]
2026-04-11 sim: drop $write to stdout from UART monitor — verilator buffer race garbles it
    The fast UART TX bus capture used to mirror each byte both to uart.log
    ($fwrite) and to verilator's stdout ($write) so the boot would scroll
    live in the terminal where Vtb_soc_top runs. Verilator's own stdout
    buffering interleaves badly with per-character $write calls and
    internal verilator output, producing garbled noise around the real
    characters (each line picks up a few stray bytes from elsewhere).
    uart.log itself is fine. Drop the $write and document the canonical
    live-boot recipe in the README:
    ./Vtb_soc_top --timeout 1000000000 # in one terminal
    tail -f flows/simulation/uart.log # in a sec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
    [tb_soc_top.v]
2026-04-11 linux/patches: re-add cpufeature.c unaligned-check disable
    I incorrectly reverted this hunk during the cleanup pass. The
    check_unaligned_access initcall does
    start_jiffies = jiffies;
    while ((now = jiffies) == start_jiffies)
    cpu_relax();
    which busy-waits on the timer IRQ bumping jiffies. At this initcall
    stage on ntiny the SBI timer chain doesn't service the kernel side
    predictably enough — the loop never exits and Linux hangs at
    c0002b90..c0002b9c forever (PC sampler stays inside the 16-byte loop).
    Re-disable the initcall (the per-cpu unaligned-access-speed hwcap is
    only used by hwprobe consumers, which we don't have).
    Patch is now 14 lines across 3 files:
    - arch/risc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
2026-04-11 sim: stop uartdpi from mirroring every byte to stderr
    uartdpi_write() called fputc(data, stderr) for every byte that came
    out of the bit-by-bit serializer, on top of forwarding it to the PTY.
    That stderr mirror leaked the slow serialized stream into the terminal
    where Vtb_soc_top runs (the verilator process inherits the user's
    stderr), interleaving with the testbench's fast bus capture and
    producing per-character noise like
    "nIexS otSeneBEice:tro'pbo0eeIuO g x04MmtC"
    Drop the fputc. The clean copy already lives in uart.log via the
    testbench's fast UART TX bus monitor; the PTY is still available for
    anyone who wants an interactive session via /dev/pts/N.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
    [uartdpi.c]
2026-04-11 linux: embed initramfs uncompressed to skip ~30M cycles of inflate_fast at boot
    CONFIG_INITRAMFS_COMPRESSION_GZIP=y was the default and re-gzipped
    the .cpio we pass in (which is already uncompressed). Result: every
    boot ran inflate_fast to expand the 4MB busybox cpio, burning ~30M
    sim cycles in c010cce4..c010cf38.
    Switching to CONFIG_INITRAMFS_COMPRESSION_NONE=y embeds the cpio
    verbatim. Boot is much faster from devtmpfs onwards.
2026-04-11 docs: post-Linux roadmap + extend bug catalog with bugs 19-26 (Phase 4.13)
    docs/post_linux_roadmap.md
    Roadmap for the next wave of HW work, organized into three groups
    with dependencies and rough costs:
    A. Bit manipulation completion (Zbc, Zbs, Zicond) — 3-4 sessions
    B. Random/crypto (MMIO RNG via timeriomem-rng + later kernel bump
    for native Zkr) — 1-2 sessions
    C. Branch prediction (BHT + BTB + RAS, on top of the existing
    scaffolding from commit 9acd167) — 4-5 sessions
    Pulls together the existing docs/bit_extensions_plan.md +
    memory/project_zkr_jitterentropy.md + memory/project_core_revamp_plan.md
    §14 into a single ordered checklist.
    docs/linux_bo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
2026-04-12 sim: CYC trace monitor for U-mode trap debugging (Bug 27 diagnosis)
    Re-arming per-cycle trace that fires on every U-mode trap, captures
    60 cycles of pipeline + aligner state: pc_out, pc_id, pc_ie, pc_iwb,
    fb head vaddr/word, half_index_q, is_compressed_o, aligner_pop,
    fb_count, ie_stall, tp register.
    Also adds USTART (priv 0 entry), UTRAP (U-mode interrupt_valid),
    HIGHVA (any fetch from 0xffff*), and per-trap TRAP dump with
    stvec/mtvec/vec_o for trap-target verification.
    Used to diagnose Bug 27: the 7th U-mode trap for busybox's dynamic
    linker fetches WRONG instruction bytes (0xbd55f6f4 instead of
    0x14021273) for kernel handle_exception at VA c0002de4. Root cause
    is an ITLB stale-entry bug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
    [tb_soc_top.v]
2026-04-12 mmu: abort in-flight PTW on sfence.vma (Bug 27 — ITLB stale entry)
    The PTW FSM abort condition only checked flush_i (traps/interrupts)
    but not sfence_i. When sfence.vma fired (e.g. from the dynamic
    linker's mmap path), the ITLB was correctly cleared (all valid=0),
    but an in-flight PTW walk that started before the sfence completed
    after the clear and immediately refilled the ITLB with a stale
    (pre-sfence) translation.
    Sequence that caused the crash:
    1. Dynamic linker mmap updates page tables; PTW walk in-flight
    2. sfence.vma → ITLB fully cleared
    3. In-flight PTW not aborted → completes with old PTE data
    4. tlb_fill refills ITLB with stale entry for kernel VA c0002de4
    mappi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
    [mmu_sv32.sv]
2026-04-12 fetch: gate refetch_after_trap by ~mmu_i_stall (Bug 27 real fix)
    Root cause confirmed by CYC trace with PA + itlb_hit logging:
    @127483735 pc_out=c0002de4 i_pa=00000de4 imem_req=1 itlb_hit=0
    The ITLB had no entry for the trap handler VA c0002de4 (evicted by
    user PTW FIFO fills during busybox's dynamic linker demand-paging).
    refetch_after_trap unconditionally asserted imem_port.req=1 on the
    cycle after the trap redirect — WITHOUT checking mmu_i_stall.
    With no ITLB hit, i_paddr_out defaults to the zero-init itlb_entry's
    PPN, producing PA = {0, VA[11:0]} = 0x00000de4. The bus fetched from
    this garbage PA (OpenSBI firmware region), returned 0xbd55f6f4, pushed
    it into the fetch buffer tagge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
    [core_top.sv]
2026-04-12 fetch: extend refetch_after_trap across ITLB miss PTW (Bug 28)
    Bug 27's fix (gate refetch_after_trap by ~mmu_i_stall) prevented the
    garbage-PA fetch but consumed the 1-cycle refetch_after_trap pulse
    without ever fetching the handler VA. When the PTW completed and the
    ITLB had the correct entry, refetch_after_trap was already gone and
    i_vaddr fell back to pc_in = pc_out+4. The first fetch was for
    c0002de8 (bnez) instead of c0002de4 (csrrw tp,sscratch,tp).
    Result: the csrrw was never executed, tp stayed as the user's TLS
    pointer (0x957a8300), _save_context's "sw sp, 12(tp)" wrote to a
    user VA in S-mode → store page fault → SIGSEGV → init killed.
    Confirmed by CYC[61] trace:
    @130769338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
    [core_top.sv]
2026-04-12 interrupt_ctrl: pc_for_ie fallback for IE-stage sync fault epc (Bug 29)
    Same class as Phase 4.13c (async interrupt mepc=0) but for synchronous
    data faults (load/store page fault, access fault, misalign, csr illegal).
    When a DTLB miss triggers a PTW walk, ie_stall holds pc_ie at the
    faulting instruction. But on the exact cycle the PTW completes and
    the data fault fires, the IE register wall may clear pc_ie to 0
    (interrupt_valid → ie_flush). The interrupt_ctrl reads pc_ie_i on
    the same cycle and latches epc=0.
    The kernel then returns to user at sepc=0 → insn page fault at 0 →
    SIGSEGV → init killed.
    Fix: add a pc_for_ie fallback (like pc_for_async in Phase 4.13c):
    wire pc_for_ie =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
    [interrupt_ctrl.sv]
2026-04-13 interrupt_ctrl: use registered pc_ie for data-fault epc fallback (Bug 29b)
    Bug 29's fallback `pc_for_ie = pc_ie ?: pc_out` was wrong: pc_out is
    the FETCH-stage PC (several instructions ahead of IE), so when used as
    sepc the kernel returned past the faulting load, which never
    re-executed. The same address then re-faulted from a later instruction
    → infinite page-fault loop (63 identical faults for addr 0x956cd358).
    Fix: latch pc_ie into a holding register `pc_ie_saved_q` whenever it's
    non-zero (= a real instruction in IE). This register survives through
    the PTW stall. On the exact cycle the fault fires and pc_ie is cleared
    to 0, the fallback reads pc_ie_saved_q (the faulting load's actual P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
    [interrupt_ctrl.sv]
2026-04-13 trap_sequencer: register data-fault is-store flag (Bug 30)
    interrupt_valid is gated by !insn_valid_id, which can delay the trap
    by 1+ cycles after mmu_d_fault_r asserts. During that delay the IE
    stage may flush (interrupt_valid → ie_flush schedules NOP for next
    posedge), and by the time interrupt_ctrl reads data_fault_is_store_i
    (the combinational d_store_for_mmu), it has dropped to 0. Result:
    cause is reported as 13 (load page fault) instead of 15 (store page
    fault). The kernel handles cause=13 as a read fault → maps the page
    read-only → returns → the store re-executes → same fault → infinite
    page-fault loop (115 faults for addr 0x956cd358 from busybox's
    dynamic linker writing r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
    [core_top.sv, trap_sequencer.sv]
2026-04-13 docs: add bugs 27-30 to catalog, refresh kernel patch (remove debug prints)
    Bug catalog now covers 39 bugs across 6 development phases:
    27. refetch_after_trap sends bus req with garbage PA on ITLB miss
    28. refetch 1-cycle pulse consumed during PTW → handler csrrw skipped
    29/29b. sync data fault epc=0 (pc_ie cleared + wrong pc_out fallback)
    30. store fault reported as cause=13 (load) → infinite page-fault loop
    Kernel patch refreshed: removed debug pr_info from process.c, fault.c,
    binfmt_elf.c, binfmt_script.c. Clean patch is now 3 files / 14 lines:
    - arch/riscv/boot/dts/Makefile (ntiny subdir)
    - arch/riscv/kernel/head.S (kernel_sp init)
    - arch/riscv/kernel/cpufeature.c (che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
2026-04-13 docs: condense all docs (1285 → 160 lines)
    - linux_boot_bugs_and_fixes.md: table-only format, 39 bugs in 63 lines
    - post_linux_roadmap.md: 3 groups in 47 lines
    - software/linux/README.md: quick start in 50 lines
2026-04-16 bit-ext: add Zbc (clmul/clmulh/clmulr) and Zbs (bclr/bext/binv/bset +i)
    Single-cycle Zbc (32-deep XOR tree) in design/core/alu/src/clmul.sv,
    combinational Zbs in design/core/alu/src/zbs.sv. Decoder grows four new
    funct7 cases (0000101/0100100/0110100/0010100 for the R-form, plus
    imm-form counterparts under OP_I). bit_op_e widens to 6 bits to hold
    the 11 new opcodes.
    Plumbing updates: ntiny.dts advertises zba/zbb/zbc/zbs in both
    riscv,isa and riscv,isa-extensions; RISCOF ISA YAMLs declare Zbc/Zbs
    so the compliance tests get selected; spike plugin extends the
    --isa string with _zbc/_zbs (the stock plugin only wired up _zba/_zbb,
    so the spike ref hung on every Zbc/Zbs instruction).
    Validation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
2026-04-20 bpu: add BHT+BTB+RAS + per-half IF-stage prediction infrastructure
    ID-stage BPU (BHT+BTB+RAS) working and giving the established
    +5.7% Dhrystone / +4.3% CoreMark gain:
    * BHT: gshare 1024x2-bit, 8-bit GHR (XOR with pc[9:1])
    * BTB: 128-entry direct-mapped, tagged with is_uncond + is_compressed
    * RAS: 8-entry shift-register stack (jalr return prediction)
    * Training at IE (branch resolve), ID-stage lookup at pc_id
    * Unified redirect: bpu_bht_btb_fire (BHT/BTB) || ras_pop_fire (RAS)
    IF-stage per-half prediction infrastructure is wired up and enabled
    but currently perf-neutral/slightly slower (squash+pending overhead
    roughly cancels the savings). Further tuning deferred to future work.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
    [bht.sv, bpu.sv, btb.sv, compressed_aligner.sv, core_pkg.sv, core_top.sv, fetch_pkg.sv, hazard_unit.sv]
2026-04-21 bpu: combinational squash exit + broader pending_q clear
    Two small optimizations to reduce IF-stage BPU overhead:
    Opt A (compressed_aligner.sv): combinational squash exit.
    Previously the aligner emitted the target's first instruction ONE
    cycle after the target word arrived at buffer head (squash_q=1 →
    instruction_valid_o=0 on the arrival cycle, squash_q=0 on the next).
    Now eff_half_idx overrides half_index_q with squash_target_q[1] on
    the exit cycle, and eff_squash (vs squash_q) keeps instruction_valid_o
    and pop_o on the normal emit path — saves 1 cycle per predicted-taken
    branch.
    Opt B (core_top.sv): broaden bpu_if_pending_q clear.
    Previously pending cleared only on BR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
2026-04-25 fetch: DEPTH 2→4 + refetch-on-overflow (+29% dhry, +39% CM)
    Three fixes in design/core/core_top/src/core_top.sv enable DEPTH=4
    fetch_buffer with full speculation throughput:
    1. DEPTH 2→4 with wider fetch_stall threshold (count==DEPTH-1 +
    inflight). fb_count widened to 3 bits.
    2. Refetch-on-overflow (new fb_overflow clause in pending_target_q):
    When BPU IF redirect fires near a full buffer, the legitimate
    concurrent rvalid push fills the last slot, then the target rvalid
    (1 cycle later) overflows and is dropped. The aligner squash FSM
    then waits forever for head.vaddr == target. Fix latches the
    dropped vaddr into pending_target_q so the existing pending-target
    mecha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
    [core_top.sv, tb_soc_top.v]
2026-04-25 bpu: disable RAS pop-fire to fix Linux boot regression
    The Return Address Stack at ID stage was driving the unified ID-stage
    redirect via `bpu_redirect_fire = bpu_bht_btb_fire || ras_pop_fire`. With
    RAS active, Linux reproducibly hangs at the kernel's first csrw satp
    transition: an instruction page fault fires at c0001058 (= PA 0x80401058,
    inside relocate_enable_mmu, between the trampoline-pgdir satp write and
    the second satp write), the trap dispatches to stvec which the kernel
    just set to a panic-wfi loop, and the kernel parks there forever.
    Bisected via incremental bypassing on commit 3cd6194 (the BPU
    infrastructure commit):
    - BPU fully off (pred_taken_o=0 + bpu_*_redirect_fire=0): Lin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
    [core_top.sv]
2026-04-25 bpu: disable IF-stage prediction to fix Linux boot under Svadu
    With Svadu HW A/D updates active, the BPU IF (per-half IF-stage
    prediction with aligner squash) interacts with the PTW's in-flight
    PTE writeback in a way that corrupts a kernel data load. Linux v6.6
    hits BUG at drivers/of/address.c:401 in of_match_bus during PLIC
    init: the loop's final beqz on the NULL match field of the default
    bus reads as non-NULL, the loop falls through, and BUG() fires.
    Bisected to BPU IF specifically: with BPU IF off but BHT/BTB at ID
    still on, Linux boots all the way through kernel init (516+ uart
    lines, all initcalls, into userspace init).
    - core_top.sv: tie bpu_if_redirect_fire to 0.
    - compressed_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
    [compressed_aligner.sv, core_top.sv]
2026-04-26 fetch+bpu: fix two Linux boot races (pending_target stale override + BPU JAL flush)
    Two independent races kept Linux from getting past `/bin/init` to userspace.
    1. pending_target stale-override race (S-mode, handle_mm_fault crash)
    When a deferred RDR_BRANCH (mmu_i_stall on its target) latched
    pending_target_q, and a new non-deferred RDR_BRANCH then fired in the
    SAME cycle that pending_target_v_q was still 1, pending_overrides_vaddr
    routed the redirect-cycle imem.req to the STALE target. The buffer
    ended up with a stale head + post-redirect next; the aligner stitched
    them into a bogus instruction. Reproduced as /init crashing in
    handle_mm_fault at c0075180 with a3=0xffff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
    [core_top.sv, tb_soc_top.v]
2026-04-28 csr: hold S-mode MIP bits (STIP/SEIP/SSIP) — fix Linux scheduler livelock
    The MIP register's update logic clobbered all 32 bits from interrupt_src_i
    every non-CSR-op cycle, but interrupt_src_i only carries the HW-driven
    level signals (MTIP[7], MEIP[11], MSIP[3]). The SW-controlled S-mode bits
    (STIP[5], SEIP[9], SSIP[1]) — which OpenSBI sets via `csrsi mip, 0x20`
    in its legacy timer flow — were instantly cleared on the next clock
    edge.
    Net effect: Linux never received an S-mode timer interrupt. The
    scheduler never preempted, voluntary-preemption loops never got the
    chance to call schedule(), and the kernel livelocked in
    shmem_get_folio_gfp / __filemap_get_folio cmpxchg retries the mome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
    [csr_unit.sv]
2026-04-28 trap: fix async-trap epc + spurious IWB-flush dual bug
    Two distinct bugs blocking Linux boot, both async-trap correctness:
    1. interrupt_ctrl: pc_for_async used pc_id (younger, fetch-stage PC).
    When c.j/jal/c.jr is in EX redirecting, pc_id holds the WRONG-PATH
    sequential next-fetch — IF hasn't seen the redirect yet. Async
    firing this cycle captured wrong epc → kernel resumed on wrong
    path after sret → state corruption (random.c BUG_ON in crng_make_
    state, smoking gun trap @6828568 captured c0151e3e instead of
    c0151e3c). Fix: prefer pc_ie when branch_taken_i — re-executing
    branches/jumps is idempotent.
    2. core_top: wb_event_fire included wb_trap_fire even though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
    [core_top.sv, interrupt_ctrl.sv]
2026-04-28 hazard: imem_flush on async trap with branch_taken (3rd async-trap fix)
    Third bug in the async-trap chain. With pc_for_async=pc_ie (commit
    3a8db86's fix) and iwb_flush=FALSE on async traps (same commit),
    the IE-stage instruction's writeback was no longer killed — but my
    pc_for_async fix says we'll re-execute it. So IE→IMEM→IWB propagates
    the doomed instruction and its rd write fires, even though we've
    captured its PC as epc.
    For jumps with rd=x0 (c.j, c.jr without link, branches), this is
    harmless — the re-executed instruction would write the same value
    (or no value). My commit 3a8db86 happened to only encounter such
    benign cases in the older initramfs's address layout.
    After rebui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
    [core_top.sv, hazard_unit.sv]
2026-04-28 dv_tracer: extend to full core tracer + tb cleanup + run_linux flag
    Tracer (verification/dv/src/tracer.sv):
    - Add HTI-aligned trap events (priv, trap_valid, trap_cause, trap_epc,
    trap_tval, trap_to_s, xret_fire, xret_is_sret, xret_target).
    - Add separate trap log (trace_core_<id>_traps.log).
    - Add window control via plusargs: tracer_start_cycle/stop_cycle,
    tracer_start_pc/stop_pc — avoids multi-GB logs over a full Linux boot.
    - Factor print_reg helper, compact CSR table, drop dead code.
    Testbench (flows/simulation/testbench/tb_soc_top.v):
    - Remove all debug instrumentation (pc_sampler, sie/tp/pf/ra trackers,
    perf counters). All debug now lives in dv_tracer.
    Build (flows/simulation/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
    [tb_soc_top.v, tracer.sv]
2026-04-28 csr: combine IE-stage csr_cmd writes with trap entry MSTATUS updates
    Async-trap epc captures pc_id (the instruction AFTER the IE-stage
    one), implying the IE-stage CSR write has effectively committed.
    Previously the trap-entry path overwrote _MSTATUS with the trap
    update and the IE-stage csr write was lost.
    Smoking gun (Linux boot, 2026-04-28): default_idle_call's
    csrrsi sstatus,2 (set SIE) was being suppressed when an M-timer
    trap fired the same cycle. Kernel resumed past the csrrsi with
    SIE still 0. do_idle's SIE-set check then triggered WARN_ON in
    kernel/sched/idle.c:228.
    Fix: two-step combinational compute. csrrw_next applies the
    IE-stage CSR write, then mstatus_next applies trap/ret bi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
    [csr_unit.sv]
2026-04-28 trap: fix async-trap epc for multi-cycle IE-stage ops (gate on ie_stall)
    When an async (timer) interrupt fires while a multi-cycle op is in
    the IE stage (AMO mid-FSM, MUL/DIV in flight, PTW pending, etc), the
    op has not yet committed but the legacy epc capture used pc_id (the
    instruction *after* the IE-stage one). After sret, the kernel
    resumed past the aborted op — silently dropping its effect.
    Smoking gun (Linux boot, chr_dev_init hang, 2026-04-28):
    c002d600: amoadd.w a4, a4, (a0) ← up_write decrement of rwsem.count
    c002d604: andi a4, a4, 2 ← check FLAG_WAITERS
    M-timer fires before amoadd.w retires. Captured mepc=c002d604.
    amo_unit aborts (state→IDLE on flush). Ker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
    [core_top.sv, hazard_unit.sv, interrupt_ctrl.sv]
2026-04-30 amo: defensive flush_i gate on bus drive
    Suppress dbus_read_o / dbus_write_o when flush_i is asserted, so an
    async trap firing during AMO_READ/AMO_WRITE can't cause a partial
    commit (memory updated AND AMO aborted internally → re-execution
    double-applies on retry).
    Empirically the race did not fire over a 100M-cycle Linux boot (a
    test counter showed 0 flush-during-AMO_WRITE events), but the gate
    is correct per AMO atomicity semantics and costs nothing.
    [amo_unit.sv]
2026-04-30 amo: stall amo_unit while PTW owns dmem bus (xas_load livelock fix)
    dmem_port is shared between PTW (highest prio), amo_unit, and the core
    load/store unit. Mux drives req/we/wdata/addr/be from whichever master
    ptw_active/amo_active selects, but ready/rvalid/rdata fan out to all
    masters. amo_unit.dbus_stall_i sampled rvalid/ready raw — when Svadu
    PTW pre-empted the bus mid-AMO_READ, amo_unit consumed PTW's response
    as its own. read_data_q captured a PTE word, the AMO writeback
    computed (PTE OP rs2_q) and stored it, and CAS loops corrupted memory.
    Manifested as folio refcount underflow → 6.6 xas_load livelock at
    ~88M cycles, and as 6.12 NULL-prev in __schedule_bug (corrupted
    pcpu_alloc_mut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
    [core_top.sv]
2026-04-30 tb: add debug probes used to diagnose the AMO/PTW + ash bugs
    Five probes added to tb_soc_top.v (each writes its own log file):
    1. s6_watch.log — watches x22 (s6) writebacks and __schedule_bug
    entry. Caught the Linux 6.12 NULL-prev recursion. PCs are 6.12-
    specific (c0028032 / c01d8cbe / c01d91b8); dormant on 6.6.
    2. amo_ptw_race.log — counts cycles where amo_unit's FSM is non-IDLE
    and ptw_active=1, plus the smoking-gun "AMO_ADVANCE_IN_PTW" event
    when amo_state transitions while PTW owns the bus. Drove the
    xas_load-livelock root-cause and verifies the fix in core_top.sv
    (commit b7009f3) — count drops to zero post-fix.
    3. c2a_ptw_race.log — analogous probe for reg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
    [tb_soc_top.v]
2026-04-30 docs: add bus + memory architecture revamp plan
    Phased roadmap for moving away from the current static-priority signal-mux
    arbiter (which is what enabled the AMO/PTW response-leak bug fixed in
    b7009f3):
    Phase 0 (DONE) — point-fix amo_unit.dbus_stall_i with ptw_owns_bus
    Phase 1 — proper dmem_arb module with grant signals to each master
    (removes the entire response-leak bug class)
    Phase 2 — L1I + L1D caches, MMU integration, atomic line semantics
    Phase 3 — AXI master interface to a DRAM controller
    Phase 4 — coherence / multicore (long-term)
    Includes audit checklist for similar bug classes (core2avl+PTW race,
    iPTW+fetch race, misalign-split-during-PTW, AMO+sfen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
2026-05-01 repo: consolidate build flow, move tracer to TB, route logs to logs/
    Big cleanup pass following Linux-6.6 boot HW exoneration:
    * tracer: remove ~100-line DV_TRACER block from core_top.sv. New
    flows/simulation/testbench/tb_tracer.sv hosts the IE→IMEM→IWB
    pipeline-state regs and tracer instance, reaches into core_top via
    hierarchical refs. Design carries zero trace footprint.
    * logs: all $fopen paths in tb_soc_top.v + tracer.sv now write to
    flows/simulation/logs/. mkdir -p logs runs at TB startup. clean
    target wipes the whole logs/ dir.
    * run scripts: delete legacy shims (run_riscof.sh, run_save_context.sh,
    run_tests.sh). Keep run_linux.sh (does real work) and surface it as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
2026-05-01 tb: v4 ash globals-write snoop — milestone, ntiny boots to login prompt
    Adds a streaming HW-side probe that snoops every U/M/S-mode write to
    the 5 PAs that ash uses for its parser globals (wordtext, lasttoken,
    quoteflag, tokpushback, checkkwd at PA 0x80cf0470..0x80cf0487 in our
    busybox build). Streams to logs/ash_globals.log, flagging writes that
    come from PCs outside the parser-code range or non-U-mode privilege
    levels as <UNAUTH>.
    What this caught (and corrected understanding):
    * Kernel S-mode writes to those PAs DO happen — but they are normal
    exec-time setup, not corruption: __clear_user (PC 0xc01bd390+)
    zeroing fresh user BSS pages after a copy-on-write page fault, then
    __me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
    [tb_soc_top.v]
2026-05-02 bpu: hold ID-stage prediction redirect while ie_stall is high
    Diagnosis
    =========
    busybox-ash misparsing /init line 9 ("unexpected in") was traced to
    strcmp returning 0 after a single byte comparison instead of looping
    to byte 1. Decoding the libc strcmp at PC 0x000a2674..0x000a268a:
    a2674: lbu a5, 0(a0)
    a2678: lbu a4, 0(a1)
    a267c: bne a5, a4, 0xa2686 <-- dropped from pipeline
    a2680: addi a0, a0, 1
    a2682: addi a1, a1, 1
    a2684: bnez a5, 0xa2674
    a2686: sub a0, a5, a4
    a268a: ret
    In the failing iteration the lbu at a2678 missed DTLB and stalled IE
    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
    [core_top.sv]
2026-05-02 bpu: gate ID-stage prediction on consumer_can_take (proper fix)
    Supersedes the !ie_stall bandaid in 5236f1e by replacing it with the
    architectural invariant: the BPU at ID may fire only when ID is
    actually consuming the branch this cycle. ie_stall was the only stall
    source we had a reproducer for, but the same hazard exists for every
    other if_id_stall input — a load-stalled bne was just the easiest one
    to hit because PTW cycles are long.
    Mechanism (now general)
    =======================
    hazard_unit exposes a new output `consumer_can_take_o` defined as the
    same OR-list as if_id_stall_o minus the id_no_insn_stall (=~aligner_valid)
    term. It captures "ID can accept a new instruction this cycle,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
    [core_top.sv, hazard_unit.sv]
2026-05-02 flows/sim: tighten Verilator warning policy + NO_TRACER env knob
    Two related infrastructure tweaks to the Linux-sim launcher:
    Warning policy
    ==============
    Drop -Wno-UNOPTFLAT, -Wno-CASEINCOMPLETE, -Wno-MULTIDRIVEN,
    -Wno-WIDTH, -Wno-UNSIGNED. These mask correctness-relevant problems
    that we've now run into: the BPU-at-ID branch-drop hazard was a
    combinational loop (UNOPTFLAT), and the codebase has truncations
    (WIDTH) that have been silently lurking. Keep -Wno-INITIALDLY,
    -Wno-UNUSED, -Wno-PINMISSING, -Wno-STMTDLY, -Wno-UNPACKED,
    -Wno-LITENDIAN, -Wno-MODDUP, -Wno-MISINDENT — all style /
    Verilator-specific cleanup categories with many benign instances.
    Add --Wno-fatal so a new UNOPTFLAT is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
2026-05-02 rtl: silence Verilator CASEINCOMPLETE / WIDTHTRUNC noise + real fixes
    Companion to the run_linux.sh warning-policy tightening. The codebase
    had ~120 long-suppressed Verilator warnings; this pass triages them
    into "real but harmless, silence cleanly" vs "actual truncation, fix".
    CASEINCOMPLETE — silenced via lint_off pragmas / default clauses
    ================================================================
    decoder.sv (14 sites), c_dec.sv (1 site)
    Both decoders use the canonical "default at top of always_comb +
    case branches override" idiom. Unmatched opcode/funct slots fall
    through to the top defaults. Wrap each always_comb in
    /* verilator lint_off CASEINCOMPLETE */ ... lint_on so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
    [alu.sv, c_dec.sv, crc_avalon_wrap.v, decoder.sv, divider.sv, fetch_buffer.sv, gpio_top.sv, i2c.sv]
2026-05-02 rtl: eliminate UNOPTFLAT loops via ctrl_bus_if_id_raw on ID consumers
    After the consumer_can_take BPU gate landed, three combinational loops
    remained on interrupt_ctrl's ecall_valid / ebreak_valid / illegal_valid.
    All three closed through the same chain:
    bpu_redirect_fire
    -> ctrl_bus_if_id.predicted_taken (line 1531 always_comb merge)
    -> [downstream consumer reads ctrl_bus_if_id]
    -> illegal_insn_id / ebreak_raw / ecall_raw
    -> {ecall,ebreak,illegal}_valid (interrupt_ctrl)
    -> interrupt_valid
    -> amo_unit -> amo_dbus_read
    -> mmu_d_access_fault -> ie_stall
    -> consumer_can_take -> bpu_bht_btb_fire = bpu_redirect_fire
    The downstream consumers (p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
2026-05-02 software/linux: chain apply-patches into build + add initramfs-rebuild
    Two reproducibility fixes for the Linux build flow.
    Gap 1: apply-patches not auto-chained
    =====================================
    The kernel rule did `make olddefconfig` only — that fills in newly
    introduced symbols but never re-installs ntiny_defconfig from the
    source tree. Editing software/linux/ntiny_defconfig and running
    `make build` therefore silently kept the previous .config. This
    trap is exactly what hid the psmouse Oops in the recent debug
    session: the leftover CONFIG_INPUT=y from a prior build pulled the
    PS/2 driver stack into vmlinux, whose __param table tripped a
    kernfs refcount underflow in param_sysfs_built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
2026-05-02 linux/tb: bump UART to 250k baud + clean up TB probes
    UART speedup:
    - 115200 -> 250000 baud at both ends (testbench/tb_soc_top.v BAUD
    param + opensbi platform UART_BAUDRATE divisor 199).
    - Restore TXFULL poll in ntiny_uart_putc. At 250k baud the per-byte
    stall is ~2000 cycles — affordable, and necessary to pace TX so
    uartdpi's RX state machine doesn't race back-to-back bytes (that
    race produced clean uart.log byte snoops but corrupted PTS output
    at 1M and 5M baud).
    TB cleanup:
    - Exploratory Linux/userspace bug-triage probes (NULL-prev s6 watch,
    PTW-after-load detector, vDSO pointer tracker, etc.) wrapped behind
    `ifdef ENABLE_DEBUG_PROBES — off by defaul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
    [platform.c, tb_soc_top.v]
2026-05-02 linux/tb: implement UART RX, enable FTRACE_SYSCALLS, strip TB probes
    OpenSBI ntiny console:
    - Implement ntiny_uart_getc reading UART_RX (offset 0) gated by
    UART_STATUS_RXVALID (bit 0). Linux HVC over SBI v0.1 now
    receives chars typed at the socat-connected PTY end-to-end:
    socat -> PTY -> uartdpi -> SoC UART RX -> SBI getc -> HVC ->
    agetty. Tested: root login on 'hvc0' works.
    Linux defconfig:
    - Re-enable CONFIG_FTRACE=y + CONFIG_FTRACE_SYSCALLS=y so syscall
    enter/exit tracepoints can be turned on at runtime via
    /sys/kernel/tracing/events/syscalls/enable. Costs ~10-30%
    boot wallclock (mcount stubs + tracepoint dispatch) but unlocks
    full kernel observability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
2026-05-02 docs: peripheral standardisation + Linux integration plan
    Multi-session plan to refactor ntiny's 7 custom peripherals (UART, SPI,
    I2C, GPIO, PWM, TIMER, CRC) to upstream Linux IP register layouts so
    the in-tree kernel drivers (sifive,uart0/gpio0/spi0/pwm; opencores,
    i2c-ocores) bind directly. Avoids writing/maintaining custom kernel
    drivers; we get sysfs GPIO, /dev/spidev*, i2cdetect, /dev/ttyS0,
    hardware PWM "for free".
    Phasing: Phase 1 = DT scaffolding + driver Kconfigs (low risk, no RTL
    change). Phase 2 = per-peripheral RTL refactor sequenced GPIO -> UART
    -> I2C -> SPI -> PWM, each landing as ONE commit covering RTL +
    software/drivers/<periph>/ + software/tests/<periph>/ — these three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
2026-05-02 linux: phase 1 — peripheral DT scaffolding + driver Kconfigs
    DT (software/linux/ntiny.dts):
    - Add nodes for all 7 ntiny peripherals targeting upstream Linux IP
    layouts: serial=sifive,uart0; spi=sifive,spi0; gpio=sifive,gpio0;
    i2c=opencores,i2c-ocores; pwm=sifive,pwm0. TIMER + CRC = generic-uio.
    - Add fixed-clock node @ 50 MHz; SiFive/OCores drivers all need a
    clock handle.
    - All peripheral nodes ship status="disabled" until their Phase 2
    RTL refactor + the Phase 1.5 PLIC S-mode prerequisite both land —
    enabling them now crashes inside plic_irq_enable (NULL deref) the
    moment any driver requests an IRQ, because PLIC HW + opensbi
    declare M-mode context only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
2026-05-02 phase 1.5: PLIC dual-context (M+S) + SEIP HW signal through core
    The Phase 1 DT scaffolding boot exposed that any peripheral driver
    requesting an IRQ NULL-derefs inside plic_irq_enable+0x30 — there was
    no S-mode context to register an S-mode handler against. Linux runs in
    S-mode; without a context for it, the entire Phase 2 sequence is
    blocked. This commit wires the full SEIP path end-to-end.
    PLIC RTL (design/uncore/plic/src/plic_rv.sv):
    - NUM_CONTEXTS=2: ctx 0 = M-mode, ctx 1 = S-mode.
    - Per-context state: enable[ctx], threshold[ctx], claim_id[ctx].
    - Gateway state stays per-source (PLIC spec: claim from any context
    locks the gateway until any context completes).
    - Address de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
2026-05-04 peripherals: gpio: standardise to sifive,gpio0
    Phase 2a of the peripheral standardisation plan. Refactors the ntiny
    GPIO RTL register layout to match SiFive GPIO0 so the in-tree Linux
    driver (drivers/gpio/gpio-sifive.c) binds directly without writing or
    maintaining a custom kernel driver.
    RTL (design/uncore/gpio/src/gpio_top.sv):
    - Full register-map rewrite to SiFive layout: input_val/input_en at
    0x00/04, output_en/val at 0x08/0C, rise/fall/high/low IE+IP at
    0x18..0x34, out_xor at 0x40. PUE/DS/IOF_EN/IOF_SEL stub as
    RAZ/WI (ntiny pads have no PU/DS/IOF).
    - Per-pin IRQ output: rise/fall edge detector + level monitors.
    interrupt_reg[i] = (rise_ip & rise_ie) | ... per pin.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
    [gpio.c, gpio.h, gpio_defs.h, gpio_test.c, gpio_top.sv, soc_top.sv]
2026-05-04 core: fix async-trap epc for T->NT branch mispredict
    When a backward branch is predicted-taken but resolves not-taken
    (loop-exit case), the legacy async-trap epc logic captured
    branch_target_address — which is always the would-be TAKEN target,
    not the fall-through. If a timer/external interrupt fired on the
    exact same cycle as such a mispredict, the kernel's saved epc was
    the loop top, sret resumed inside the loop, and the loop ran
    forever. Symptom: kernfs_name_hash hash loop spinning until 32-bit
    wrap (~4 GB iterations) on a perfectly NUL-terminated 9-byte
    string, only triggered when initramfs.cpio size shifts by 4 KB
    (timer phase aligns with the bne mispredict on a specific
    iteration of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
    [core_top.sv, interrupt_ctrl.sv]
2026-05-04 tb: trap + kernfs_name_hash probes (debug aids, off by default)
    Two probes added during the layout-sensitive boot-hang investigation
    (2026-05-03), kept in-tree as they're cheap and reusable for the next
    layout-sensitive trap-race bug:
    trap_probe.log: every committed trap (sync exception or async
    interrupt) with cause/satp/sstatus/tp/sp/epc/tval. Filter is
    `wp_int_v` so only commits land in the file. Useful for
    storm-detection ("are we taking the same trap repeatedly?")
    and for reading kernel context at fault sites.
    kfh_progress.log: kernfs_name_hash entry samples + bne-resolution
    samples (s1, a0, branch_taken, predicted_taken, mispredict,
    ie_flush). Filter to S-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
    [tb_soc_top.v]
2026-05-04 linux: ship boot-time peripheral self-test in initramfs
    Adds /etc/init.d/S95peripherals to the buildroot rootfs. Runs at boot
    before getty, prints PASS/FAIL per peripheral subsystem, and saves
    the report to /var/log/ntiny-peripheral.log.
    - GPIO (Phase 2a): probes /sys/class/gpio/gpiochipN, drives pin 0
    high/low via sysfs and confirms readback + register state via
    /dev/mem (devmem 0x1003000C).
    - UART/I2C/SPI/PWM stubs: print SKIP until the matching Phase 2b/c/d/e
    standardisation lands; then automatically promote to PASS when
    /dev/ttyS0, /dev/i2c-0, /dev/spidev*, /sys/class/pwm/pwmchip0
    appear.
    The buildroot post-build script that installs this file lives outside
    the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
2026-05-04 peripherals: uart: standardise to sifive,uart0
    Phase 2b of the peripheral standardisation plan. Refactors the ntiny
    UART register layout to match SiFive UART0 so the upstream Linux driver
    (drivers/tty/serial/sifive.c) binds and exposes /dev/ttySIF0. HVC
    console keeps going through OpenSBI throughout the transition (Phase 3
    will retire the HVC path once ttySIF0 is the primary console).
    RTL (design/uncore/uart/src/{uart_top.sv,uart_defs.sv}):
    - Full register-map rewrite to SiFive layout: txdata at 0x00 (write
    data + bit31 = full flag on read), rxdata at 0x04 (bit31 = empty,
    [7:0] = data), txctrl/rxctrl at 0x08/0x0C, ie/ip at 0x10/0x14,
    div at 0x18.
    - Bit-level TX/RX FSMs prese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
    [platform.c, tb_soc_top.v, uart.c, uart_def.h, uart_defs.sv, uart_test.c, uart_top.sv]
2026-05-04 peripherals: i2c: standardise RTL to opencores,i2c-ocores layout
    Phase 2c of the peripheral standardisation plan. The bit/byte
    controllers under design/uncore/i2c/ are already derived from
    OpenCores (Richard Herveille's WISHBONE I2C). What needed refactoring
    was the avalon-side register decode, which used the legacy ntiny
    mapping (prescale16 / ctrl / rx / status / tx / cmd at 6 separate
    word offsets) instead of the upstream i2c-ocores driver's expected
    layout (prelo / prehi / ctrl / data{tx-or-rx} / cmd-or-status at
    5 word offsets, with reg-shift=2 + reg-io-width=4 in DT).
    RTL (design/uncore/i2c/src/i2c.sv):
    - Replace REG_CLK_PRESCALER/REG_CTRL/REG_RX/REG_STATUS/REG_TX/REG_CMD
    with RE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
    [i2c.c, i2c.sv, i2c_defs.h, i2c_test.c]
2026-05-04 docs: peripheral standardisation progress + remaining plan
    Companion to the strategy doc (peripheral_standardization_plan.md).
    Tracks per-peripheral status, lists the prereq commits (Phase 1 DT
    scaffolding, Phase 1.5 PLIC dual-context, the pc_for_async fix), and
    lays out concrete RTL plans for the remaining Phase 2d (SPI) and
    Phase 2e (PWM) refactors.
    - Phase 2d (SPI): the existing ntiny SPI is Xilinx-style (DGIER /
    IPISR / IPIER / SRR / CR / SR / DTR / DRR / SSR). SiFive SPI0 is
    a different model entirely; this is a near-complete RTL rewrite.
    Estimated 4-6 hours.
    - Phase 2e (PWM): existing ntiny PWM is dual-channel with deadtime
    and complementary/redundant modes. SiFive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
2026-05-04 docs: i2c kernel-side debug notes + Phase 5 IEEE-standards plan
    Phase 2c follow-up:
    - The Phase 2c RTL refactor (256d66f) is verified end-to-end at
    bare-metal level. Enabling the i2c DT node triggers a kernel-side
    bug in init (NULL deref in get_page_from_freelist with
    LEGACY_PTYS=y, silent sysctl hang with LEGACY_PTYS=n).
    - Static audit ruled out: I2C RTL stays quiescent after probe (ctrl
    bit 7 not set until last write, bit 6 IEN never set, byte_controller
    stays ST_IDLE, no spurious irq_flag); PLIC sources_i wiring matches
    DT interrupts=<4>; bare-metal driver works on the new register
    layout. Strongest remaining hypothesis is the same layout-sensitive
    page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
2026-05-04 docs+tb: i2c crash forensic analysis + sync-fault probe
    Static decode of the prior i2c-enabled crash dump (no new sim run):
    Faulting insn at c00b2f3a is c.sw a2, 4(a3), NOT 4(a0). The compressed
    encoding's rs1' field decodes to a3 (x13), not a0 — that's why
    badaddr=0x4 matches a3=NULL+4 rather than a0+offset.
    The surrounding code is the standard list_del epilogue inside
    get_page_from_freelist:
    lw a2, 4(a5) ; a2 = entry->prev
    lw a3, 0(a5) ; a3 = entry->next (NULL — fault source)
    sw a2, 4(a3) ; *(NULL+4) = a2 ← traps
    sw a3, 0(a2)
    sw s6, 0(a5) ; entry->next = LIST_POISON1 (0x100)
    sw s4, 4(a5) ; entry->prev = LIST_POISON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
    [tb_soc_top.v]
2026-05-04 peripherals: i2c: enable Linux driver — Phase 2c end-to-end verified
    Flips software/linux/ntiny.dts i2c@10020000 from status="disabled" to
    status="okay". Linux's i2c-ocores driver now binds to the refactored
    RTL and registers /dev/i2c-0. Self-test reports:
    gpio.driver PASS label=10030000.gpio base=512 ngpio=2
    gpio.sysfs PASS drive 1/0 readback ok (1/0)
    gpio.devmem PASS output_val mmio = 0x00000001 / 0x00000000
    uart.driver SKIP /dev/ttyS0 absent (test grep is wrong — driver
    actually registers /dev/ttySIF0; cosmetic)
    i2c.driver PASS /dev/i2c-0 present (i2c-ocores bound)
    --- summary: 4 pass, 0 fail ---
    Earlier in the same branch,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
    [tb_soc_top.v]
2026-05-04 peripherals: spi: standardise RTL to sifive,spi0 layout
    Phase 2d of the peripheral standardisation plan. The previous SPI used
    a Xilinx-style register layout (DGIER / IPISR / IPIER / SRR / CR / SR /
    DTR / DRR / SSR / CLK_RATIO at 8'h1c..0x74). Rewrites the avalon-side
    register decode to match drivers/spi/spi-sifive.c (sckdiv 0x00,
    sckmode 0x04, csid/csdef/csmode 0x10/0x14/0x18, delay0/1 0x28/0x2c,
    fmt 0x40, txdata/rxdata 0x48/0x4c, txmark/rxmark 0x50/0x54,
    fctrl/ffmt 0x60/0x64 RAZ/WI, ie/ip 0x70/0x74).
    RTL (design/uncore/spi/src/spi.sv, spi_defs.sv):
    - Full register-decode rewrite to SiFive layout. Bit-shift FSM is
    preserved bit-for-bit from the legacy implementation (proven CPOL/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
2026-05-04 peripherals: spi: enable Linux driver — Phase 2d end-to-end verified
    Flips spi@10010000 from status="disabled" to enabled (default) and adds
    a spidev child node so userspace gets /dev/spidev0.0. Closes Phase 2d.
    DT changes:
    - Drop status="disabled". The RTL refactor in bc4a4f5 already matched
    the upstream sifive,spi0 layout; this just turns on the probe.
    - Add spidev@0 child (compatible="rohm,dh2228fv"). Modern spidev.c
    rejects "linux,spidev" — that name is a Linux class, not a device,
    and the driver explicitly errors out on it ("spidev listed directly
    in DT is not supported"). rohm,dh2228fv is the canonical throwaway
    compatible used by countless boards for spide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
2026-05-04 peripherals: pwm: standardise RTL to sifive,pwm0 layout
    Phase 2e of the peripheral standardisation plan. The previous PWM was
    a custom dual-channel design (period1/period2 + compare1/compare2 +
    deadtime + complementary/redundant + center-aligned modes) at word-
    indexed offsets 0..7. Rewrites to the upstream sifive,pwm0 layout
    (drivers/pwm/pwm-sifive.c): single 31-bit free-running counter, four
    independent 16-bit compare channels, byte-addressed register map at
    PWMCFG=0x00 / PWMCOUNT=0x08 / PWMS=0x10 / PWMCMP[0..3]=0x20..0x2c.
    Drops the deadtime + complementary modes. They can be re-added later
    as a custom extension if motor-control workloads need them.
    RTL (design/uncore/pwm/src/pwm_top.sv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
2026-05-04 peripherals: pwm: enable Linux driver — Phase 2e end-to-end verified
    Drops status="disabled" on the pwm node. The RTL refactor in 412ae7d
    already matched the upstream sifive,pwm0 layout; this just turns on
    the probe.
    Boot results (uart.log):
    === ntiny peripheral self-test ===
    spi.driver PASS /dev/spidev0.0
    pwm.driver PASS /sys/class/pwm/pwmchip0 present
    --- summary: 6 pass, 0 fail ---
    The pwm-sifive driver binds quietly (no dev_info on s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
2026-05-05 core: BPU/ie_flush race — capture branch at IE-wall when BPU wins arbiter
    When BPU at ID predicts a branch taken, it asserts arb_redirect_valid
    which combinationally drives imem_port.req → mmu_i_stall_o (live). That
    lifts if_id_stall and triggers hazard_unit case 4'b1000 → ie_flush=1
    the SAME cycle. The IE register's "ie_flush || interrupt_valid" clause
    then captures NOP and the branch is dropped. The aligner is reseated
    to the predicted target by the same redirect, so target instructions
    flow through and commit "as if" the branch had taken — but the branch
    itself never resolves at IE.
    The existing consumer_can_take gate uses REGISTERED mmu_i_stall_q to
    break the comb loop, leaving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
    [core_top.sv, tb_soc_top.v]
2026-05-05 linux: boot self-test — fix i2c.sysfs path, skip i2cdetect probe
    - i2c.sysfs: switch from /sys/class/i2c-adapter/i2c-0/name (legacy,
    gone in v7.0+) to /sys/bus/i2c/devices/i2c-0/name. Removes a
    spurious FAIL on the 7.0 boot (the controller IS bound — the test
    was just looking at an obsolete sysfs class).
    - i2c.probe: SKIP i2cdetect. The bus scan hangs userspace in a
    kernel ioctl — i2c-ocores driver waits for an IRQ that never fires
    (PLIC mapped 7 lines but the i2c controller's line isn't reaching
    the driver). Re-enable once PLIC routing is investigated.
    Self-test summary on Linux v7.0 with this change:
    18 pass / 1 fail (i2c.sysfs path still wrong, this commit fixes)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
2026-05-06 core+linux: enable Sstc + narrow async-trap re-execute gate to AMO mid-FSM
    Adds Sstc (S-mode timer compare extension) end-to-end so Linux can
    program stimecmp directly via CSR write, eliminating one SBI ecall
    per scheduler tick. Also fixes a pre-existing async-trap double-execute
    bug exposed by the higher Sstc tick rate.
    == Sstc ==
    - csr_unit: STIMECMP (0x14D) / STIMECMPH (0x15D) registers; HW STIP
    injection into mip.STIP/sip.STIP when (mtime >= {STIMECMPH, STIMECMP})
    and menvcfg.STCE (= menvcfgh[31] on RV32) is set; new outputs
    menvcfg_stce_o / stimecmp_o for downstream observation.
    - core_pkg: STIMECMP / STIMECMPH csr_reg_e codes.
    - opensbi platform: csr_set(menvcfgh, BIT(29) | BIT(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
    [core_pkg.sv, core_top.sv, csr_unit.sv, interrupt_ctrl.sv, platform.c]
2026-05-06 benchmarks: bump uart_init baud to 250000 to match uartdpi
    The bare-metal benchmarks (CoreMark / Dhrystone) called
    `uart_init(115200)` which programs the UART divisor for 115200 baud,
    but the simulation testbench instantiates uartdpi with BAUD=250000
    (set in tb_soc_top.v line 106 — moderate speedup over 115200 while
    still well below the failure points seen at 1M/5M baud where uartdpi
    RX races back-to-back SoC TX). The mismatch garbled output: uartdpi
    couldn't decode the bytes, so logs/uart.log captured the raw bus
    writes correctly but the PTY consumer saw mush.
    Fixed scores produced clean stdout via the fast-console probe:
    CoreMark : 174.66 Iterations/Sec (TEST PASSED)
    Dhrystone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
2026-05-07 core: pc_for_async fallback uses pc_ie+insn_len when ID is empty
    v7.0 with Sstc-driven timer interrupts crashed in terminate_walk
    with ra=0xfffff000. Root cause: when the ID stage was empty
    post-context-switch, pc_id=0 and the legacy fallback in
    pc_for_async picked pc_ie raw — so sepc was set to the IE-stage
    instruction's PC, and sret re-executed that instruction. For
    mntput's `addi sp,-16` that meant a double-decrement, walking sp
    past the saved-ra slot until the loaded ra was a stale word
    (PAGE_MASK constant from a slab page) and ret jumped to fffff000.
    - interrupt_ctrl: new c_valid_ie_i input. When pc_id=0, fall
    back to pc_ie + (c_valid ? 2 : 4) so we skip Z (which has
    a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
    [core_top.sv, interrupt_ctrl.sv]
2026-05-08 core: fix async-trap+IE-branch and async-trap+IE-AMO collisions
    Two related sepc-capture bugs surfacing in Linux v7.0:
    Layer 3 (xas_load misalign): when async-trap fires the same cycle as
    a CORRECTLY-PREDICTED-TAKEN branch at IE, branch_taken_valid (=
    mispredict) is 0 but the branch IS architecturally taking. The old
    `async_use_branch = branch_taken_i` gate fell through to pc_ie+insn_len
    = the FALL-THROUGH PC of a branch that took, so sret resumed at the
    wrong place (xas_load returned the un-canonicalised sibling pointer
    → next_uptodate_folio's lr.w hit a misaligned addr). Fix: pass
    `branch_taken == TRUE` from branch_comp into interrupt_ctrl as
    branch_taken_h_i and OR it with the existi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
    [amo_unit.sv, core_top.sv, interrupt_ctrl.sv]
2026-05-08 tb: windowed FST + Layer-1 invariant asserts + pc_sampler
    Replace the per-bug ad-hoc \$fwrite probes in tb_soc_top.v with a
    small set of always-on diagnostics:
    * FST waveform dumping driven from main.cpp via plusargs:
    +wave_start=<cycle> open the FST and start dumping
    +wave_stop=<cycle> stop dumping (file finalised on disk)
    +wave_file=<path> output FST path (default /tmp/wave.fst)
    Build flags --trace-fst --trace-structs --trace-params --trace-threads 2
    go in run_linux.sh. Without +wave_start the trace machinery stays
    dormant. SV \$dumpvars route was abandoned because Verilator's
    runtime silently drops dumps with "previous dump at t=0" warnings;
    main.cpp owning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
    [main.cpp, tb_soc_top.v]
2026-05-08 linux: rewrite boot self-test — register-level probes, no slave deps
    The old S95peripherals checked drivers via /sys/class but didn't
    look at the actual peripheral MMIO registers, and any later step
    that issued an i2c transfer would block on ocores_poll_wait timeouts
    because the TB has no i2c slave model.
    New self-test runs three layers per peripheral:
    1. driver bind — kernel driver owns the device
    (/sys/class/gpio, /dev/ttySIF*, /dev/i2c-0,
    /sys/class/spi_master, /sys/class/pwm)
    2. devmem probe — read peripheral MMIO registers directly via
    devmem and verify driver-programmed defaults
    match the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
2026-05-08 docs: HTML bug site, roadmap revamp, READMEs + Phase 5 peripherals
    * docs/bugs/ — new static HTML site for the bug catalog. Index page
    cross-links per-bug detail pages for the recent fixes
    (async-trap+IE-AMO, async-trap+IE-branch, BPU/IE-flush race, Sstc
    pipeline race, async-trap-when-pc_id-zero). Older bugs remain as
    table rows on the index. Replaces the markdown-only catalog.
    * docs/roadmap.md (was post_linux_roadmap.md) — drop obsolete done
    items, document the ladder: Tier 1 broaden RV32 SoC (Phase 5
    peripherals + more ISA extensions + bus revamp Phase 2) → Tier 2
    multicore → Tier 3 RV64 parametrisation → Tier 4 SoC generator.
    Reflects the long-term direction.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
2026-05-09 linux: multi-version build infra + cpio repack tooling
    LINUX_TAG-versioned LINUX_DIR (linux-v6.6 / v7.0 / v6.12 side-by-
    side under software/linux/external/), abspath-canonicalised so
    relative LINUX_DIR works from OpenSBI's build dir, INITRAMFS swap
    + release target. force-rm now removes the kbuild-incbin trail
    (usr/initramfs_data.cpio + .o + built-in.a) and OpenSBI's stale
    fw_payload.elf / .o so kernel/initramfs swaps are picked up.
    Boot self-test pruned to splash + 5 peripheral register-level
    probes (GPIO/UART/I2C/SPI/PWM); System/Filesystem/Kernel/Userspace
    sections dropped to keep wallclock under 10 min. /bin/bash shebang
    on S95peripherals avoids busybox-ash SIGBUS on first run.
    dir_to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
2026-05-09 core: shrink pc_for_async narrative comments in interrupt_ctrl
    177-line walk-through history (Phase 4.10c → 4.16, smoking-gun
    PCs, individual regression names) compressed to a 5-rule priority
    ladder. The bug rationale is now in docs/bugs/ and the project_*
    memory notes; the source comments only need to teach the gating
    decision. RTL is unchanged.
    [interrupt_ctrl.sv]
2026-05-09 debug: enable JTAG-DPI in Verilator + OpenOCD remote_bitbang cfg
    verilator_build_jtag target compiles SimJTAG.v + SimJTAG.cc +
    remote_bitbang.cc with +define+JTAG_DPI so the Vtb_soc_top binary
    opens a TCP listener on localhost:5555 ~50 cycles after reset.
    Default verilator_build is unchanged (TAP stays parked, no socket).
    software/flash/jtag_rbb.cfg points OpenOCD at the bitbang listener
    (adapter driver remote_bitbang, port 5555, 5-bit IR matching dtm.sv);
    software/flash/riscv.cfg keeps the FT232R adapter for FPGA bring-up.
    docs/debug_jtag.md walks the build → openocd → telnet → gdb path
    and flags the bug classes most likely to trip on first OpenOCD
    contact (TCK/clk_i sync drops, abs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
    [jtag_rbb.cfg]
2026-05-09 fpga: Vivado 2020.1 scaffold for Zybo Z7-10 (XC7Z010-1CLG400C)
    PL-only skeleton: ntiny_zybo_top wraps soc_top with the on-board
    125 MHz osc, BTN0 reset, LD0..3 from gpio_o[3:0], SW0..3 into
    gpio_i[3:0], UART tx/rx on Pmod JE. SPI / I2C / PWM / JTAG TAP
    are tied off in the wrapper for now.
    create_project.tcl reads flows/simulation/src.args (the canonical
    Verilator RTL list) so the project picks up RTL changes without
    hand-editing. ram_dp.sv infers BRAM in Vivado; baremetal images
    go to firmware/ram.hex before launching synth.
    No PS, no DDR — bare-metal demos run on this skeleton; Linux is
    gated on bus revamp Phase 3 (AXI4 master to PS DDR via AXI HP).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
    [ntiny_zybo_top.sv, zybo_z7_10.xdc]
2026-05-09 sim: switch VERILATOR_COMMON to --trace-fst + size jtag build for baremetal
    main.cpp uses VerilatedFstC for windowed FST waveform dumping; the
    default verilator_build was passing --trace (VCD) which left those
    symbols undefined at link. run_linux.sh's bespoke command line was
    the only build path that actually linked. Switching VERILATOR_COMMON
    to --trace-fst makes verilator_build / verilator_build_bench /
    verilator_build_jtag all link cleanly.
    verilator_build_jtag also gets +define+RAM_SIZE_BYTES=131072 so the
    66 KB software/build/baremetal.bin doesn't overflow the default 32 KB
    RAM during $readmemh.
    Verified end-to-end: OpenOCD examines the TAP (IDCODE 0x10e31913,
    mfg 0x489 SiFive, XLEN=3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
2026-05-09 debug: implement abstract GPR/FPR/CSR writes via dm command path
    The DM previously implemented only DCSR/DPC writes (in debug_ctrl)
    and abstract reads. OpenOCD-driven 'reg <name> <value>' for any GPR
    or CSR succeeded at the abstract-command layer but the new value
    never reached the regfile or csr_unit, so a follow-up read returned
    either the cached debugger value (giving the false impression it
    worked) or the actual stale architectural value.
    Wire the abstract write path through core_top:
    * dbg_csr_wr / dbg_gpr_wr / dbg_fpr_wr classify ar_ad_i per Spec
    Table 3.3 (CSR < 0x1000, GPR 0x1000-0x101f, FPR 0x1020-0x103f),
    gated on halted_o && ar_en && ar_wr so they only pulse during a
    legit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
2026-05-09 sim: clear remote_bitbang quit flag on new accept
    quit was set on the 'Q' command from the first OpenOCD session and
    never cleared. When the second OpenOCD attached, the existing
    client_fd path immediately closed the socket on the first command
    because quit was still latched, manifesting on the OpenOCD side as
    "Connection reset by peer" → "Unsupported DTM version: 12" (read
    returned EOF/garbage). Resetting quit at accept-time lets back-to-
    back debug sessions share a long-running sim binary, which makes
    the JTAG bring-up loop (attach → poke → detach → re-attach without
    restarting the simulator) workable.
    [remote_bitbang.cc]
2026-05-09 debug: implement System Bus Access (SBA) per Spec 1.0 §3.11
    DM now exposes the SBA register set (sbcs at 0x38, sbaddress0 at
    0x39, sbdata0 at 0x3c, plus the wider-bus stubs sbaddress1-3 and
    sbdata1-3 that read 0). debug_pkg gets the SBA address enum
    entries.
    OpenOCD with `set_mem_access sysbus` now drives memory through
    sbaddress0 / sbdata0:
    mww 0x80010000 0xfeedface → readback feedface (via SBA)
    UART poke at 0x10000000 → "SBA!" in uart.log
    sbcs read-back is `0x20040407` (sbversion=1, sbaccess=2 default,
    sbasize=32, sbaccess32=1, sbaccess16=1, sbaccess8=1).
    Implementation notes:
    * The SBA bus master is shared with the abstract memaccess
    (cmdtype=2) path — both drive the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
2026-05-09 docs: re-target ntiny as a full-blown RV64 Linux processor
    Reframe the roadmap from "embedded SoC that boots Linux" to
    "RISC-V Application Processor on Zybo Z7 FPGA, RVA22S64 profile,
    running a real Debian RV64 rootfs from disk."
    Concrete changes:
    * docs/roadmap.md — new "Mission" preamble. Tier 1 reordered to
    put the three top-priority items in order:
    1. Memory subsystem (DDR + write-back caches)
    2. RV64 parametrisation
    3. Real distro support (Debian RV64 rootfs, virtio-blk → eMMC)
    4. RVA22 / RVA22S64 profile compliance — explicit table of
    the ~9 mandated extensions, marking which are done.
    Tier 2 is now framed around Zybo Z7 FPGA bring-up (Z7-10 vs
    Z7-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
2026-05-10 sim: --threads 4 default + remote_bitbang accept() fix for pre-attach boot
    Two related improvements that make JTAG-DPI usable for "boot Linux,
    then attach OpenOCD when something goes wrong" workflows:
    * VERILATOR_COMMON gains -O3 --threads 4. Single-threaded Verilator
    was ~10x slower per cycle than run_linux.sh's bespoke build, so
    any JTAG_DPI build derived from VERILATOR_COMMON took 10+ min just
    to reach OpenSBI banner. With threads matching run_linux.sh, the
    jtag_linux build hits OpenSBI in ~10s of seconds.
    * remote_bitbang.cc accept() spun forever when no client was
    connected — `again = 1` was never cleared on EAGAIN, so the loop
    iterated until a client arrived. With the d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
    [remote_bitbang.cc]
2026-05-10 fpga: hello-world bring-up demo + Vivado tcl ram.hex registration
    * software/tests/hello/main.c: minimal forever-loop demo for FPGA
    bring-up. ee_printf("Hello from ntiny on Zybo Z7! count=N\n") on
    UART + counter on gpio[3:0] (= LD0..LD3) so a working bring-up
    shows BOTH UART traffic on Pmod JE and a binary counter on the
    on-board LEDs. Suitable for power-on demo / first-light proof.
    * software/Makefile: register hello via the existing TEST_TEMPLATE.
    Build: `make build/hello.bin` (skipping the dead split.py path).
    * create_project.tcl: register firmware/ram.hex as a sources_1
    Memory Initialization File so Vivado puts it on the synth-step
    search path and ram_dp's $readmemh("ram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
    [main.c]
2026-05-10 fpga: Vivado synth-blocking fixes (RTL + project tcl)
    Three changes that take ntiny from 'won't even start synth' to
    synth_design Complete with zero CRITICAL warnings:
    * design/uncore/crc/src/crc_avalon_wrap.v: crc_16_ibm_out /
    crc_16_ccit_out / crc_32_out were declared as `reg` but driven
    by lfsr_crc instance outputs. Vivado synth rejects this with
    Synth 8-685 ("variable should not be used in output port
    connection"). Changed to `wire`.
    * design/core/fetch/src/compressed_aligner.sv: squash_q /
    squash_target_q reset block mixed async (reset_i) and synchronous
    (flush_i, redirect_valid_i) controls in the same condition,
    tripping CRITICAL WARNING [Synth 8-5413] (mixed sync/async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
    [compressed_aligner.sv, crc_avalon_wrap.v]
2026-05-10 fpga: clean Vivado synth warnings (lint + RTL hygiene)
    Resolve the surviving non-blocking warnings from the synth_1 run on
    top of the earlier crc/compressed_aligner fixes:
    * core_top.sv: add a forward-declaration block at the top of the
    module body for ~30 wires (aligner_*, bpu_*, fb_*, d_*, fetch_*,
    arb_redirect_*, branch_taken_valid, ret_valid_valid, xret_*,
    inflight_pred_*) that were previously used at line 271+ but
    declared 500-2400 lines later. Vivado fell back to implicit 1-bit
    nets at first use (Synth 8-992 / Synth 8-6901), which is benign
    for 1-bit signals but a silent truncation hazard for the [31:0]
    ones (aligner_pc_id, *_target, d_vaddr_pre). Each later
    `wire foo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
    [c_controller.sv, core_top.sv, crc_avalon_wrap.v, soc_top.sv]
2026-05-10 fpga: forward-decl sweep across the remaining use-before-decl warnings
    Same pattern as the core_top.sv sweep: predeclare the wire (with the
    correct width) before its first use, then convert the later defining
    `wire foo = expr;` into `assign foo = expr;` so the original locality
    of the driver is preserved. Covers the modules Vivado was still
    flagging with Synth 8-6901 / Synth 8-992:
    * design/core/csr_unit/src/csr_unit.sv — `csr_active` (3 sites)
    * design/core/fetch/src/compressed_aligner.sv — `squash_head_is_target`
    * design/core/interrupt/src/interrupt_ctrl.sv — `ie_csr_illegal`
    * design/core/mmu/src/mmu_sv32.sv — `ptw_pmp_denied` (3 sites)
    * design/uncore/plic/src/plic_rv.sv — `c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
    [compressed_aligner.sv, csr_unit.sv, interrupt_ctrl.sv, mmu_sv32.sv, plic_rv.sv, soc_top.sv]
2026-05-10 linux: standalone make run + per-tag patches + OpenSBI v1.8 plic_data fix
    * software/linux/Makefile:
    - 'make run' now depends on 'build', which depends on 'prepare'.
    One command from clean: 'make run LINUX_TAG=vX.Y' clones (if
    needed), patches, rebuilds kernel + OpenSBI + ram.hex, and
    launches the sim. Re-running is idempotent.
    - apply-patches no longer swallows patch failures with
    `|| echo "(already applied or no-op)"`. New logic: try
    --reverse --check first (already applied?), then --check
    forward (clean apply?), else FAIL with a manual-intervention
    pointer. Silent fall-throughs masked the v7.0 patch mismatch
    that produced an unpatched tree.
    - KERNEL_P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
    [platform.c]
2026-05-10 sim: tracer OFF by default in run_linux.sh
    A full Linux boot with DV_TRACER on produces 12+ GB of
    trace_core_*.log — almost always the wrong default. Flip the gate:
    tracer is OFF unless TRACER env var is set with explicit
    +tracer_start_pc / +tracer_stop_pc plusargs.
    TRACER='+tracer_start_pc=00043fd6 +tracer_stop_pc=00044362' make run
    The previous NO_TRACER env-var path is removed; tracer is now opt-in.
2026-05-10 toolchain: repoint to multilib /opt/riscv-elf + /opt/riscv-linux-gnu
    The 2026-05-10 toolchain consolidation merged the three /opt/riscv*
    trees into two multilib installs (built from riscv-gnu-toolchain
    2026.05.06: gcc-15 + binutils-2.46):
    /opt/riscv-elf — riscv64-unknown-elf, multilib:
    rv32imc/ilp32, rv32imafc.../ilp32f,
    rv64imac/lp64, rv64imafdc/lp64d
    /opt/riscv-linux-gnu — riscv64-unknown-linux-gnu, multilib:
    lib32/ilp32, lib32/ilp32d,
    lib64/lp64, lib64/lp64d
    Updates:
    * software/Makefile: TOOLCHAIN /opt/riscv → /opt/riscv-elf, and the
    ARCH line is padded to the exact mu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
2026-05-10 linux: switch CROSS_COMPILE to riscv64-unknown-linux-gnu- multilib
    The 2026-05-10 toolchain consolidation collapsed the per-target
    riscv32-* and riscv64-* triplets into a single multilib
    riscv64-unknown-linux-gnu- compiler (at /opt/riscv-linux-gnu).
    The kernel arch/riscv/Makefile detects RV32 vs RV64 from
    CONFIG_64BIT and passes -march/-mabi automatically, so the same
    multilib compiler covers both 32-bit and 64-bit targets — drop
    the riscv32-* spelling that the new toolchain doesn't ship.
    Verified: 'make build' clean for both LINUX_TAG=v6.6 and v7.0
    against the new toolchain.
2026-05-10 linux: add v6.12-specific kernel patch
    Two-hunk patch that mirrors what v7.0 needs:
    * arch/riscv/boot/dts/Makefile — `subdir-y += ntiny` slotted into
    v6.12's specific subdir-y order (after renesas).
    * arch/riscv/kernel/head.S — TASK_TI_KERNEL_SP init at line 322
    (the v6.12 _start_kernel block ends with `addi sp,-PT_SIZE_ON_STACK
    + scs_load_current` whereas v7.0 has `scs_load_init_stack` — same
    insertion point either way).
    Lets `make run LINUX_TAG=v6.12` go end-to-end on the new strict
    apply-patches gate.
2026-05-17 riscof: unblock build + run on this box (no trace, fixed paths)
    flows/simulation/testbench/main.cpp Guard the VerilatedFstC code
    with #if VM_TRACE_FST so the testbench builds whether or not
    --trace-fst is passed. The RISCOF Makefile builds with no trace
    flag (RISCOF doesn't need waveforms), and the non-RISCOF flow
    still gets the wave-window machinery as before.
    verification/riscof/Makefile Drop the bare --trace from
    VERILATOR_FLAGS. That flag enables VCD trace generation but
    main.cpp uses VerilatedFstC — without --trace-fst the link
    failed with "undefined reference to VerilatedFst::*". Now
    RISCOF builds the testbench with no trace code, link
    succeeds.
    verification/ris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
    [main.cpp]
2026-05-17 README: document .env / .init bootstrap + refresh RISCOF status
    Adds a "One-time setup" section pointing at .env (single source of
    truth for tool paths) and .init (one-shot venv + arch-test bootstrap).
    Refreshes the RISCOF compliance line with the current count:
    225 PASS / 27 FAIL / 3 MISSING out of 255. The historic 204/5 record
    stands — the arch-test suite grew from 209 to 255 tests since.
2026-05-18 mmu: fault on unmapped PA so vm_sv32 access-fault tests pass
    The bus silently returned 0 for loads/stores to PAs outside any
    addr_decoder region: periph_bridge keeps ready=1 always and the
    regular load path doesn't gate on rvalid. Spike instead fires
    load_access_fault on unbacked PAs, so the 13 rv32i_m/vm_sv32/*
    RISCOF tests all diverged on the same missing trap (M-mode trap-
    handler restore at PC=0x80000ccc loading from PA=0x1d0 via a
    stale t1=0).
    Add an unmapped-PA check in mmu_sv32 that mirrors addr_decoder's
    slave selects (RAM, BOOT, peripheral 0x100x0000, CLINT, PLIC,
    tohost) and OR it into d_access_fault_o for settled non-PTW data
    requests. RISCOF: 225 -> 238 PASS (+13). Linux v7.0 st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
    [mmu_sv32.sv]
2026-05-18 pmp+trap: spec-correct S/U default-deny and mtval=0 for ebreak
    pmp_checker: the no-match default-deny in S/U was gated on
    any_active (at least one entry not in OFF mode), but per Priv
    §3.7.1 the deny rule is keyed on PMP being IMPLEMENTED, not on
    any entry being active. With 16 entries hardwired in this DUT,
    PMP is always implemented — so a hart with all entries set to
    OFF still has to deny S/U accesses. Drop the gating. Fixes
    rv32i_m/pmp/pmps_none + pmpu_none.
    interrupt_ctrl: mtval for breakpoint was set to the trapping VA
    (pc_for_id). Spec leaves it implementation-defined (0 or the
    faulting VA); spike picks 0. RISCOF's arch_test M-mode trap
    handler then uses a tval∉code-segment check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
    [interrupt_ctrl.sv, pmp_checker.sv]
2026-05-19 core_top: classify AMO access-faults as store/AMO (cause 7)
    d_store_for_mmu was set from amo_dbus_write during AMO accesses, so
    the MMU saw is_store=0 during the AMO's internal read phase and
    reported any PMP/access fault as cause=5 (load access fault). Per
    Priv §3.7 an AMO is architecturally a read-modify-write and faults
    must be reported as cause=7 (store/AMO access fault) regardless of
    which bus phase tripped them. Pin is_store=1 whenever the AMO unit
    owns the dport.
    Fixes rv32i_m/pmp/pmpzaamo_cfg_wr (42 differing lines went to PASS
    on cause-code mismatches between AMO read-phase faults and spike).
    RISCOF: 242 -> 243 PASS (+1).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
    [core_top.sv]
2026-05-19 trap: emit illegal-inst encoding in mtval (spike convention)
    Priv §3.1.16 leaves mtval for illegal-instruction implementation-
    defined: 0 or the offending instruction bytes. ntiny wrote 0 for
    both the IE-stage csr-invalid path and the ID-stage illegal-decode
    path; spike writes the encoding, and RISCOF's arch_test M-mode
    handler is built around spike's convention (it adjusts mtval by a
    code/data base and stores the result in the trap signature, so a
    zero mtval lands in a different segment than the encoding and the
    signature diverges by 1 word per trap).
    Add an `instr_word` field to ctrl_bus_e, populated from
    decoder.instruction_i so it pipelines IF→ID→IE for free, and route
    both id_ and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
2026-05-20 Revert "core_top: classify AMO access-faults as store/AMO (cause 7)"
    This reverts the AMO is_store=1 pinning from 91071b1. The change made
    d_store_for_mmu=1 during the AMO unit's internal read phase, which
    forced d_pmp_write=1 in the MMU and tripped a spurious PMP write-
    check fault on AMO reads to regions the original AMO had R for but
    not W. The fault chain corrupted amo_unit state and Linux panicked
    in folio_remove_rmap_ptes during S95peripherals (rs1 forwarded as
    garbage into a subsequent unrelated amoadd.w → misaligned-AMO Oops
    → kernel panic).
    Reverting restores Linux to clean buildroot login. pmpzaamo_cfg_wr
    remains failing — its full pass requires spike-style atomic R+W PMP
    ch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
    [core_top.sv]
