ShaheerSajid/ntiny/(notices)

Notices in the files:
design/uncore/i2c/src/i2c_master_bit_ctrl.sv:
Copyright (C) 2001 Richard Herveille
